gvayoy-web/DOMUS/assets/new/deliverables/execute/01_FINAL_V2/design/visor_mobile_390x844_cerrado.png

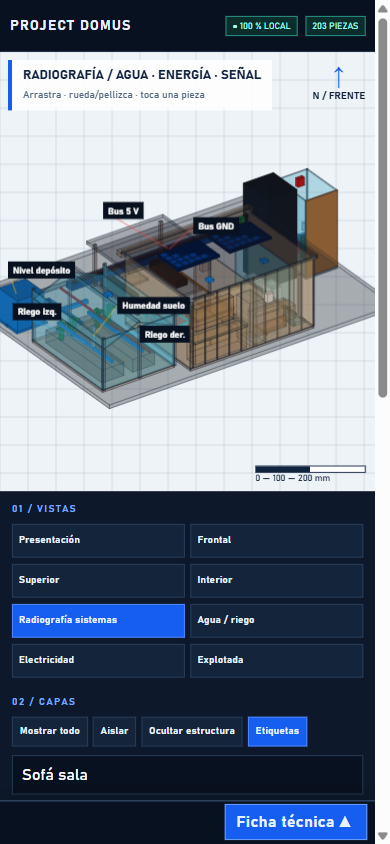
assets/new/deliverables/execute/01_FINAL_V2/design/visor_mobile_390x844_cerrado.png
