gvayoy-web/DOMUS/assets/new/deliverables/execute/01_FINAL_V2/design/visor_desktop_1440x900.png

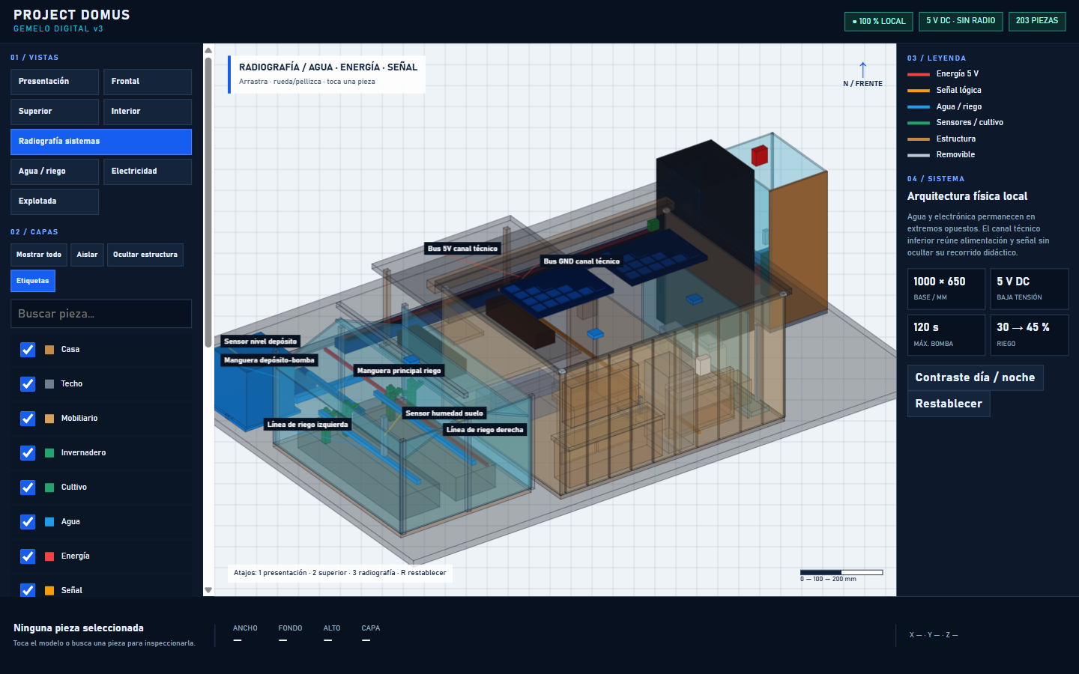
assets/new/deliverables/execute/01_FINAL_V2/design/visor_desktop_1440x900.png
