gvayoy-web/DOMUS/obsidian/proyect domus/07 - Precios y fuentes Honduras.md

---
proyecto: PROJECT DOMUS
tipo: fuentes
actualizado: 2026-09-01
estado: historico_precios
---

# Precios y fuentes en Honduras

> [!NOTE]
> Precios vistos el 1 de septiembre de 2026. Confirmar variante, existencia, envío y costo final a Choluteca en el carrito o por WhatsApp.

| Producto | Precio visto | Fuente |
|---|---:|---|
| Fuente 5 V/3 A USB-C con switch | L350 | [C&D — Fuente Raspberry Pi, elegir variante exacta](https://sps.cdtechnologia.net/2985-fuente-para-raspberry-pi3-pi4.html) |
| Relé 4 canales 5 V/10 A | L250 | [C&D — selector 1 a 8 canales](https://sps.cdtechnologia.net/2719-865-modulo-rele-5-24v-10a-1-8-canales.html) |
| MAX98357A | L130 | [C&D — amplificador I2S](https://sps.cdtechnologia.net/5855-modulo-amplificador-de-audio-i2s-max98357.html) |
| Altavoz 4 Ω/3 W | L90 | [C&D — parlante](https://sps.cdtechnologia.net/4094-parlante-4ohm-3w.html) |
| microSDHC 32 GB | L159 | [Steren Honduras — MSD-032ST](https://www.steren.com.hn/memoria-microsd-hc-de-32-gb-clase-uhs-iu1-v10-a1-con-adaptador-sd.html) |
| microSD Lexar 32 GB | L300 | [C&D — Lexar 32 GB FAT32](https://sps.cdtechnologia.net/4042-memoria-microsd-lexar-32-128gb.html) |
| Lector/escritor microSD SPI | L149 | [C&D — módulo lector microSD](https://sps.cdtechnologia.net/509-modulo-lector-y-escritor-de-tarjetas-micro-sd-compatible-con-arduino.html) |
| Jumpers set H/H + H/M + M/M | L250 | [C&D — Dupont 40 hilos](https://sps.cdtechnologia.net/118-1331-jumpers-de-conexion-dunpont-hh-mm-mh-40-hilos-20cm.html) |
| Conectores PCT, 4 unidades | L40 | [C&D — PCT](https://sps.cdtechnologia.net/2623-conector-de-cable-pct-2-pines-5-pines-4-unidades.html) |
| Portafusible aéreo 5×20 mm | L15 | [C&D — portafusible con cable](https://sps.cdtechnologia.net/3685-portafusible-con-cable.html) |
| Capacitores 1000 µF, 5 unidades | L35 | [C&D — selector electrolíticos](https://sps.cdtechnologia.net/179-capacitores-electroliticos-1-valor-01-1000uf-5-unidades.html) |
| Panel 5 V/1,100 mA | L280 | [C&D — selector panel 3–5.5 V](https://sps.cdtechnologia.net/4506-panel-solar-3v-55v.html) |
| CN3065 | L135 | [C&D — cargador solar](https://sps.cdtechnologia.net/4804-modulo-de-carga-baterias-de-litio-cn3065.html) |
| MT3608 USB-C | L90 | [C&D — elevador](https://sps.cdtechnologia.net/5077-estabilizador-regulador-ascendente-de-voltaje-dc-dc-mt3608-usb-c-2v-24v-a-5v-28v-2a.html) |
| BMS 1S 20 A | L85 | [C&D — sección baterías](https://sps.cdtechnologia.net/51-baterias) |
| 18650 BAK 2,500 mAh | L180 | [C&D — BAK](https://sps.cdtechnologia.net/5255-bateria-recargable-bak-18650-36v-2500mah-30a.html) |
| 18650 Steren 2,800 mAh | L249 | [Steren Honduras — 18650](https://www.steren.com.hn/bateria-recargable-li-ion-2800-mah-tipo-18650-1.html) |
| Portacelda individual 18650 | L55 | [C&D — sección baterías](https://sps.cdtechnologia.net/51-baterias) |
| KCD1-101 ON/OFF | L25 | [C&D — interruptor](https://sps.cdtechnologia.net/1612-interruptor-de-corriente-250v-6a-kcd1-101.html) |
| Palanca SPST 82600 | L55 | [Steren — switches](https://www.steren.com.hn/linea-estudiantil/switches-y-relevadores) |
| Capacitor 4700 µF/25 V | L60 | [C&D — capacitores grandes](https://sps.cdtechnologia.net/1701-capacitores-electroliticos-de-1000uf-2200uf-3300uf-4700uf-o-10000uf-1-valor-1-unidad.html) |
| Capacitor 6800 µF/25 V | L35 | [C&D — aparece como producto relacionado](https://sps.cdtechnologia.net/1701-capacitores-electroliticos-de-1000uf-2200uf-3300uf-4700uf-o-10000uf-1-valor-1-unidad.html) |

## Sin oferta hondureña verificada

- INMP441.
- 74AHCT125/74HCT14.
- Gestor solar 1S con power-path real y salida estable de 5 V/3 A.

No sustituirlos por productos con nombre parecido sin revisar interfaz y hoja de datos.

## Observaciones de envío

- Steren muestra compra en línea y en la página de la microSD indica que la tienda en línea puede entregar aun cuando no haya cobertura de tienda local.
- C&D publica venta en línea y contactos hondureños, pero el envío exacto a Choluteca debe confirmarse antes de pagar.
- El precio más bajo de microSD verificado es Steren L159. Una tarjeta va en el lector SPI del ESP32; comprar una segunda solo si se usará DFPlayer.
