gvayoy-web/DOMUS/obsidian/proyect domus/Bienvenido.md

---
estado: redireccion
fecha: 2026-09-14
---

# Bienvenido a PROJECT DOMUS

> [!IMPORTANT]
> Esta página sólo redirige. No contiene instrucciones de cableado.

Empieza en [[00 - Inicio]] y consulta [[63 - Auditoria total de Obsidian y estado real]].
Las notas antiguas conservan la evolución del proyecto, pero no sustituyen el
firmware, el diagrama vigente ni la auditoría 63.
