gvayoy-web/DOMUS/hardware/plano_tecnico_domus.pdf

PROJECT DOMUS · GEMELO DIGITAL v4

# PLANOS DE MAQUETA CRUDA

A3 apaisado · sin sensores, conexiones, cableado ni hidráulica instalada

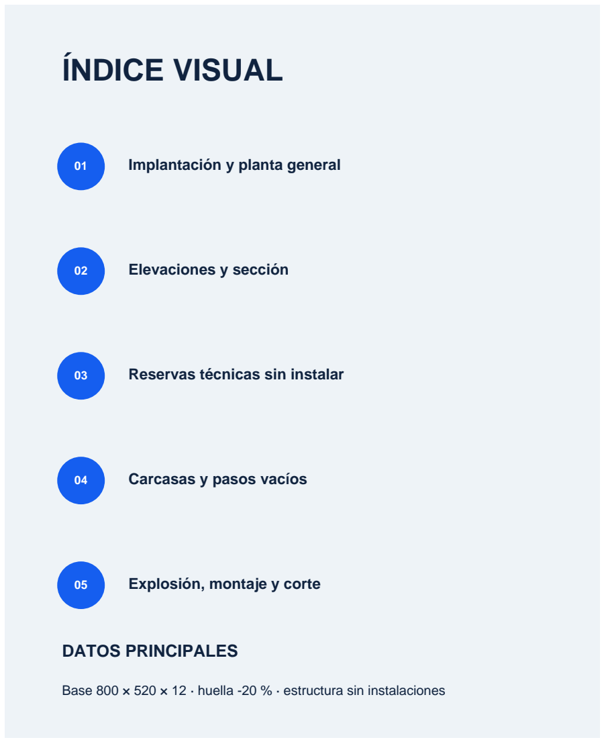
[picture p8: figure]
ÍNDICE VISUAL; 01 Implantación y planta general; 02 Elevaciones y sección; 03 Reservas técnicas sin instalar; 04 Carcasas y pasos vacíos; 05 Explosión, montaje y corte; DATOS PRINCIPALES

PL-00 · PÁGINA 1/6 · REV 4.0

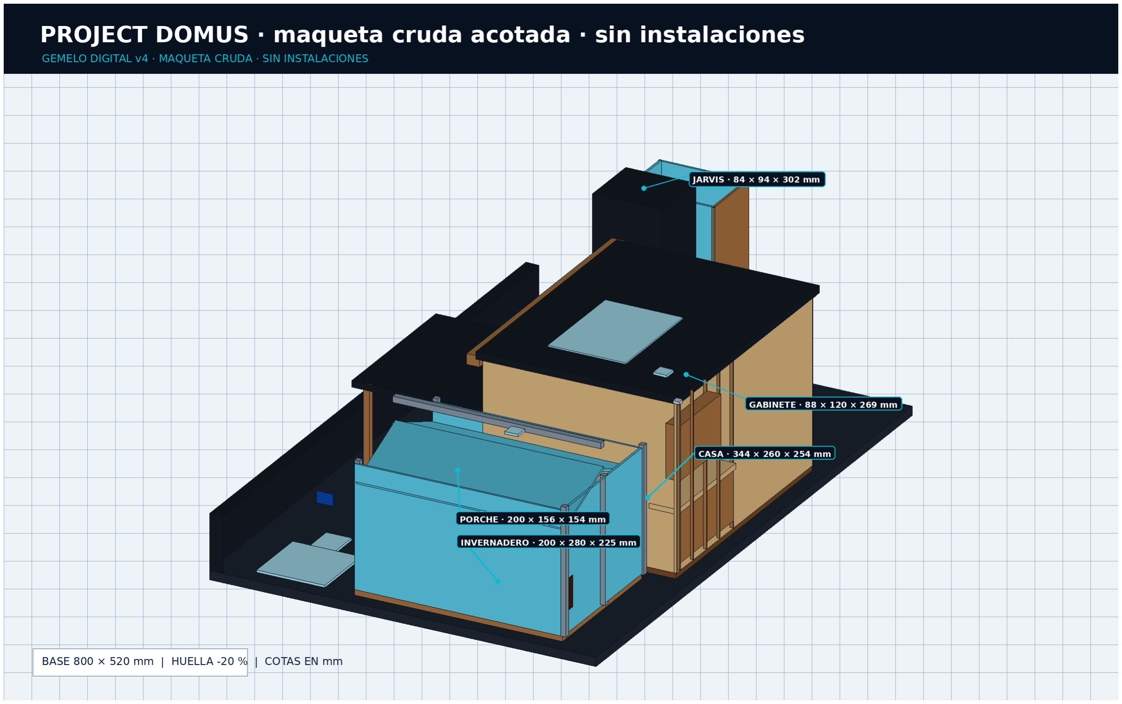
[picture p9: figure]

Base 800 × 520 × 12 · huella -20 % · estructura sin instalaciones

# IMPLANTACIÓN Y PLANTA GENERAL

Ejes, huellas y recorridos principales; el frente de exposición queda abajo

PL-01 · PÁGINA 2/6 · REV 4.0

INVERNADERO

VIVIENDA

PORCHE

JARVIS | GABINETE

AGUA

800

344 VIVIENDA

520

FRENTE / VISITANTE ↓

HUELLAS

- Invernadero 200 × 280 × 225
- Casa 344 × 260 × 254 total
- Porche 200 × 156 × 154
- Jarvis 84 × 94 × 302
- Gabinete 88 × 120 × 269
- Depósito real 92 × 92 × 100

ENTREGA DE MAQUETA CRUDA

Sin sensores, placas o conexiones.

Gabinete y Jarvis se entregan vacíos.

Canaleta inferior vacía con tapa.

Techo y frentes permanecen removibles.

# ELEVACIONES Y SECCIÓN

Alturas totales y lectura del interior abierto

PL-02 · PÁGINA 3/6 · REV 4.0

FRONTAL

344

84

SECCIÓN A-A

COCINA/SALA | DORMITORIO | BAÑO

TECHO REMOVIBLE

COTAS Z

302 torre Jarvis

269 gabinete

254 vivienda + techo

225 altura interior

225 invernadero

154 cubierta de porche

12 base estructural

ELEMENTOS REMOVIBLES

Techo · frente de gabinete · paneles de servicio

# RESERVAS TÉCNICAS · SIN INSTALACIONES

Marcar posiciones; no perforar hasta medir los componentes reales

PL-03 · PÁGINA 4/6 · REV 4.0

DEPÓSITO / 92×92
BOMBA / 48×34

JARVIS VACÍO
GABINETE VACÍO
SENSORES FUTUROS | LUCES FUTURAS | PANELES FUTUROS

REGLA PARA EL EQUIPO DE ARMADO

Construir las carcasas y marcar reservas con lápiz. No instalar placas, sensores, cables, bomba ni tubería.

# CARCASAS Y PASOS VACÍOS

Preparación mecánica para que el circuito se integre después

PL-04 · PÁGINA 5/6 · REV 4.0

### TORRE JARVIS

Frente removible; reserva pantalla/micrófono

### GABINETE

Frente removible; interior completamente vacío

### CANAL TÉCNICO

Tapa removible; no pasar cables todavía

### ENTREGA ESPERADA

1. Estructura firme y escuadrada. 2. Tapas removibles. 3. Reservas marcadas, sin agujeros definitivos.
4. Ninguna conexión, placa, sensor, actuador, manguera o fuente instalada.

# EXPLOSIÓN, MONTAJE Y CORTE

Secuencia de armado y criterios de tolerancia

PL-05 · PÁGINA 6/6 · REV 4.0

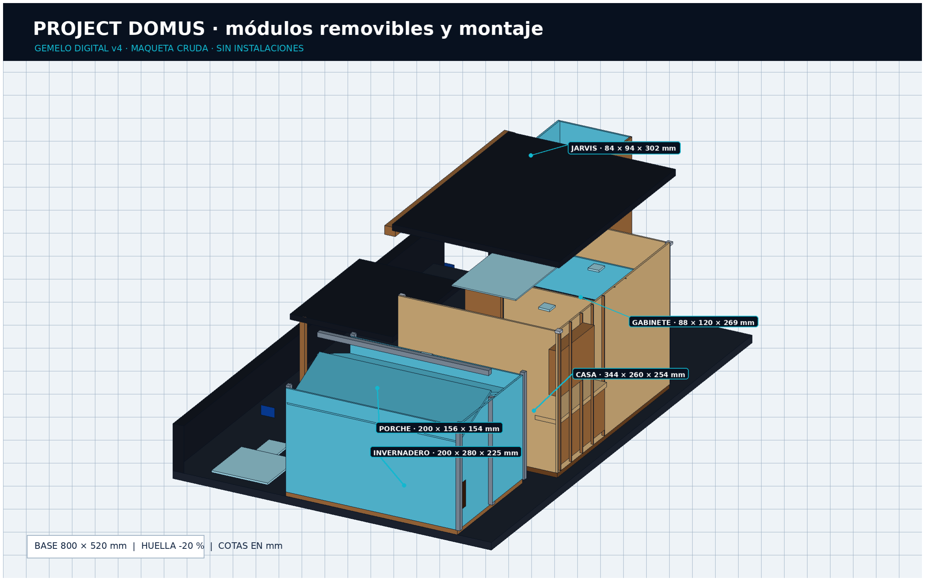
[picture p10: figure]

SECUENCIA

1 · Nivelar base 800 × 520.

2 · Marcar todas las huellas a lápiz.

3 · Montar casa y tabiques en seco.

4 · Armar porche e invernadero.

5 · Construir Jarvis y gabinete vacíos.

6 · Colocar canaleta vacía con tapa.

7 · Dejar techos y frentes removibles.

8 · Entregar sin conexiones ni perforaciones finales. TOLERANCIA INICIAL ±0.5 mm

Presentar en seco antes de adhesivo definitivo.

BASE

800×520×12

Cant. 1

CASA

344×260

Cant. 1 set

INVERNADERO

200×280×225

Cant. 1

PORCHE

200×156×154

Cant. 1

JARVIS

84×94×302

Cant. 1

GABINETE

88×120×269

Cant. 1
