gvayoy-web/DOMUS/assets/new/deliverables/execute/01_FINAL_V2/design/plano_tecnico_domus.pdf

# PROJECT DOMUS · PLANO TÉCNICO ACOTADO

Casa de una sola planta abierta al frente · cotas en milímetros · sistema totalmente local

## A · PLANTA GENERAL

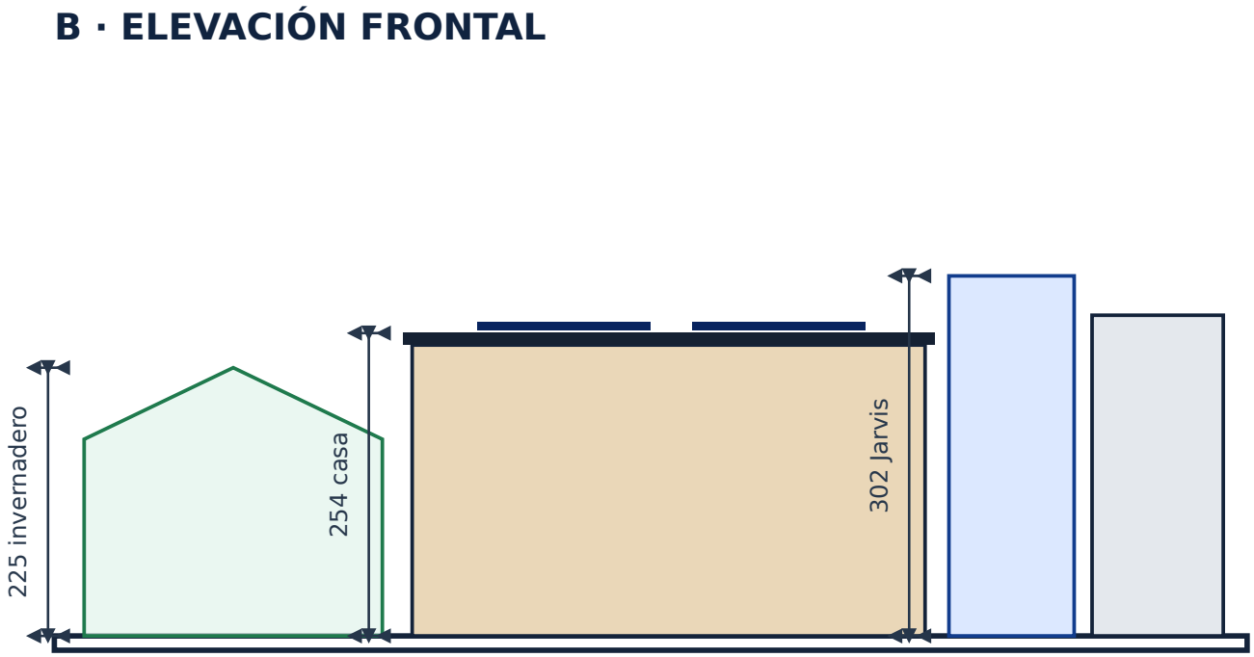
[picture p11: figure]
B · ELEVACIÓN FRONTAL 254 casa; 302 Jarvis; 225 invernadero

Frente abierto: interior visible sin desmontar una fachada

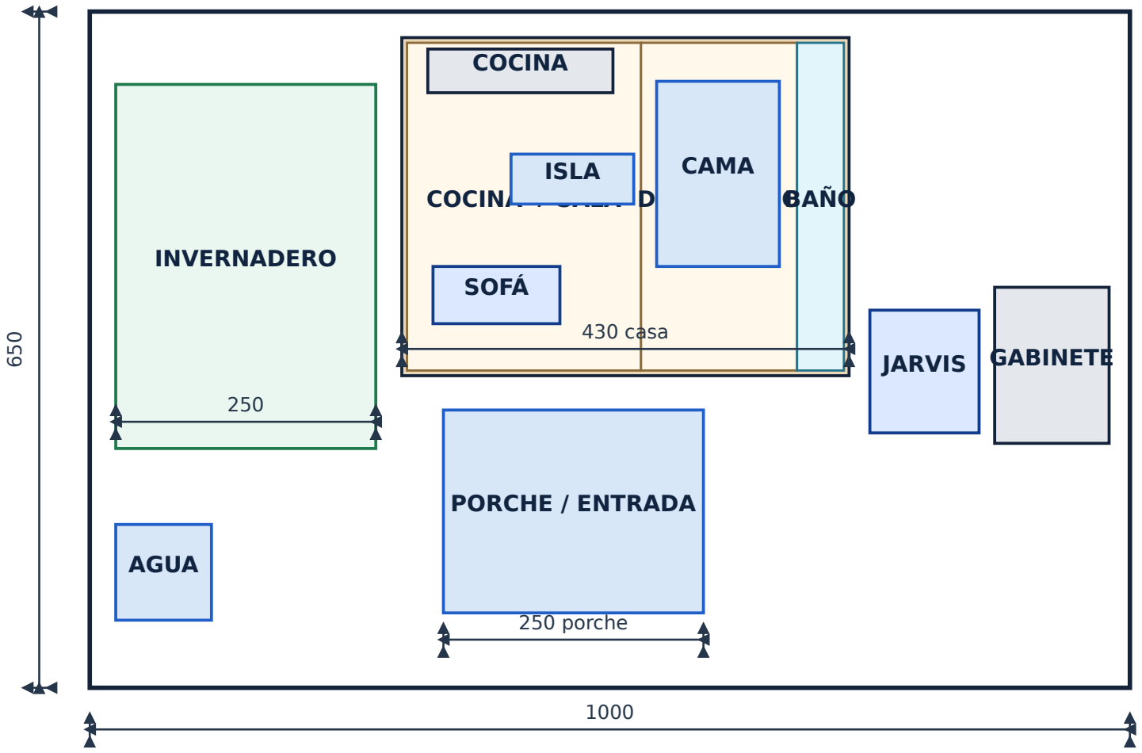
[picture p12: figure]
INVERNADERO; COCINA + SALA DORMITORIOBAÑO; PORCHE / ENTRADA; JARVIS GABINETE; AGUA; COCINA; ISLA; SOFÁ; CAMA; 430 casa; 250 porche

## C · ELEVACIÓN LATERAL DERECHA

## D · MEDIDAS PRINCIPALES

Base negra: 1000 × 650 × 12

Vivienda: 430 × 325 × 254 total · interior libre 225 de alto Invernadero: 250 × 350 × 225 · panel transparente 1–2

Porche: 250 × 195 × 154 · pasarela frontal de 58

Torre Jarvis: 105 × 118 × 302 · gabinete: 110 × 150 × 269

## E · CRITERIOS DE MONTAJE

- Una sola planta; no existe escalera ni entrepiso.
- Techo removible; fachada abierta; gabinete electrónico desmontable.
- Depósito y bomba al extremo opuesto del ESP32-S3.
- Cableado por canaleta inferior; alimentación general de 5 V DC.

SIN Wi-Fi · SIN Bluetooth/BLE · SIN teléfono · SIN nube

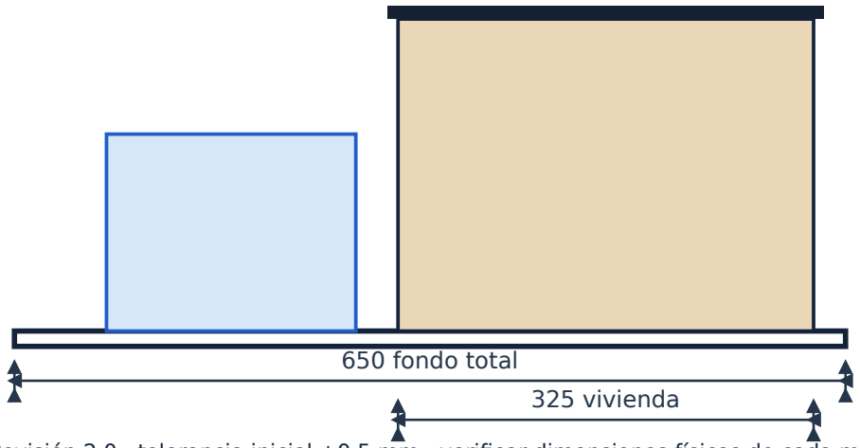
[picture p13: figure]
650 fondo total; 325 vivienda

Revisión 2.0 · tolerancia inicial ±0.5 mm · verificar dimensiones físicas de cada módulo antes del corte definitivo
