gvayoy-web/DOMUS/output/pdf/planos_tecnicos_project_domus.pdf

PROJECT DOMUS · GEMELO DIGITAL v3

# JUEGO DE PLANOS TÉCNICOS

A3 apaisado · cotas en milímetros · maqueta educativa de baja tensión

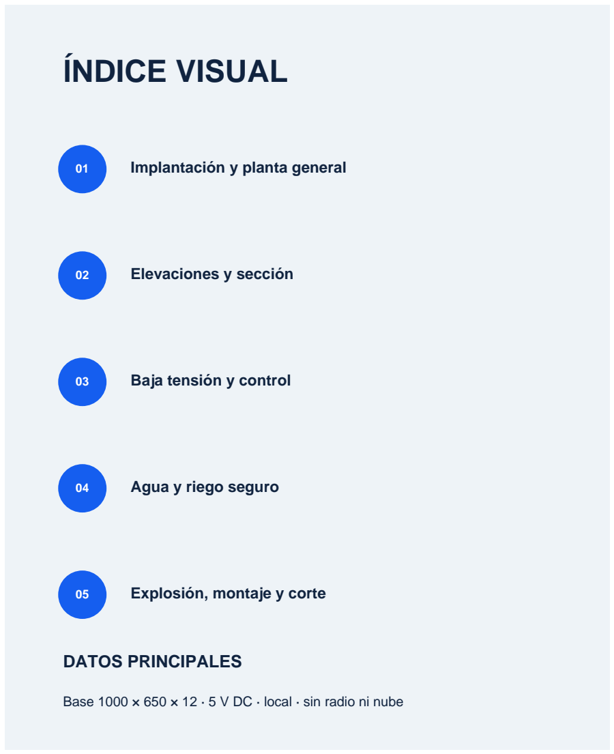
[picture p14: figure]
ÍNDICE VISUAL; 01 Implantación y planta general; 02 Elevaciones y sección; 03 Baja tensión y control; 04 Agua y riego seguro; 05 Explosión, montaje y corte; DATOS PRINCIPALES

PL-00 · PÁGINA 1/6 · REV 3.0

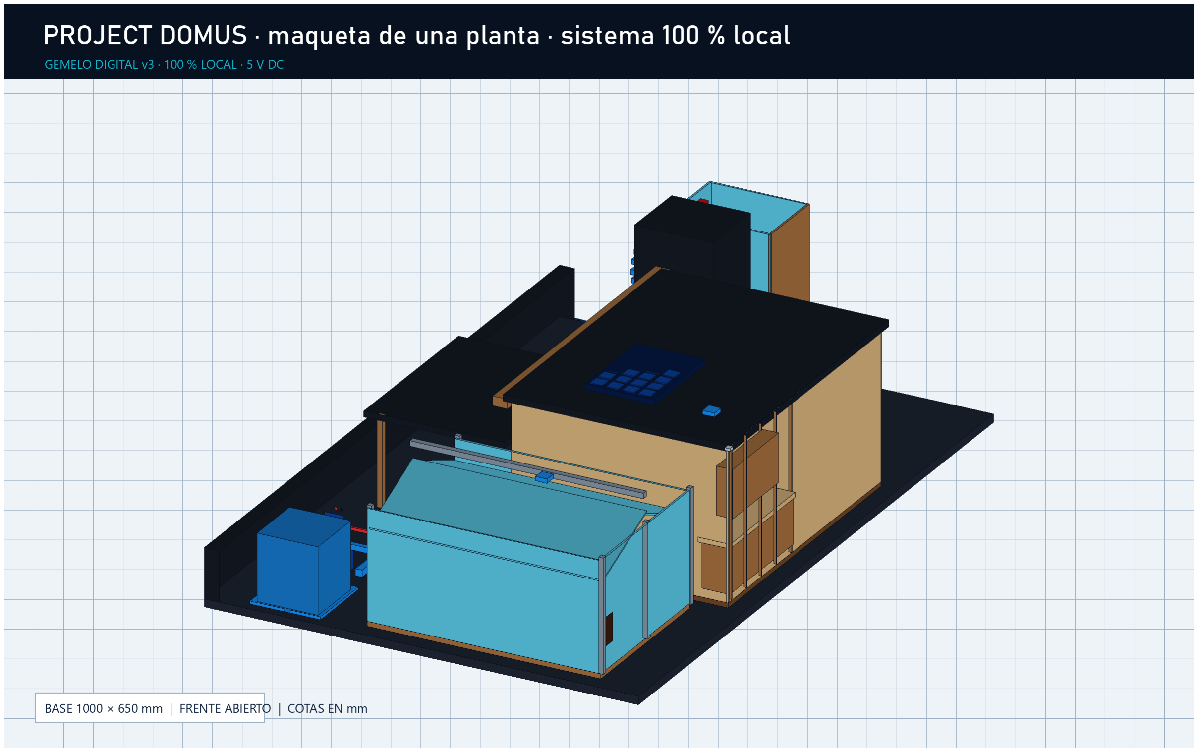
[picture p15: figure]

Base 1000 × 650 × 12 · 5 V DC · local · sin radio ni nube

# IMPLANTACIÓN Y PLANTA GENERAL

Ejes, huellas y recorridos principales; el frente de exposición queda abajo

PL-01 · PÁGINA 2/6 · REV 3.0

INVERNADERO

VIVIENDA

PORCHE

JARVIS | GABINETE

AGUA

1000

430 VIVIENDA

650

FRENTE / VISITANTE ↓

HUELLAS

- Invernadero 250 × 350 × 225
- Casa 430 × 325 × 254 total
- Porche 250 × 195 × 154
- Jarvis 105 × 118 × 302
- Gabinete 110 × 150 × 269
- Depósito 92 × 92 × 100

SEPARACIÓN FUNCIONAL

Agua al extremo izquierdo.

Control al extremo derecho.

Canaleta inferior con tapa.

Techo y gabinete removibles.

# ELEVACIONES Y SECCIÓN

Alturas totales y lectura del interior abierto

PL-02 · PÁGINA 3/6 · REV 3.0

FRONTAL

430

105

SECCIÓN A-A

COCINA/SALA | DORMITORIO | BAÑO

TECHO REMOVIBLE

COTAS Z

302 torre Jarvis

269 gabinete

254 vivienda + techo

225 altura interior

225 invernadero

154 cubierta de porche

12 base estructural

ELEMENTOS REMOVIBLES

Techo · frente de gabinete · paneles de servicio

# PLANO ELÉCTRICO · BAJA TENSIÓN

Diagrama funcional; usar la tabla de cableado validada para GPIO concretos

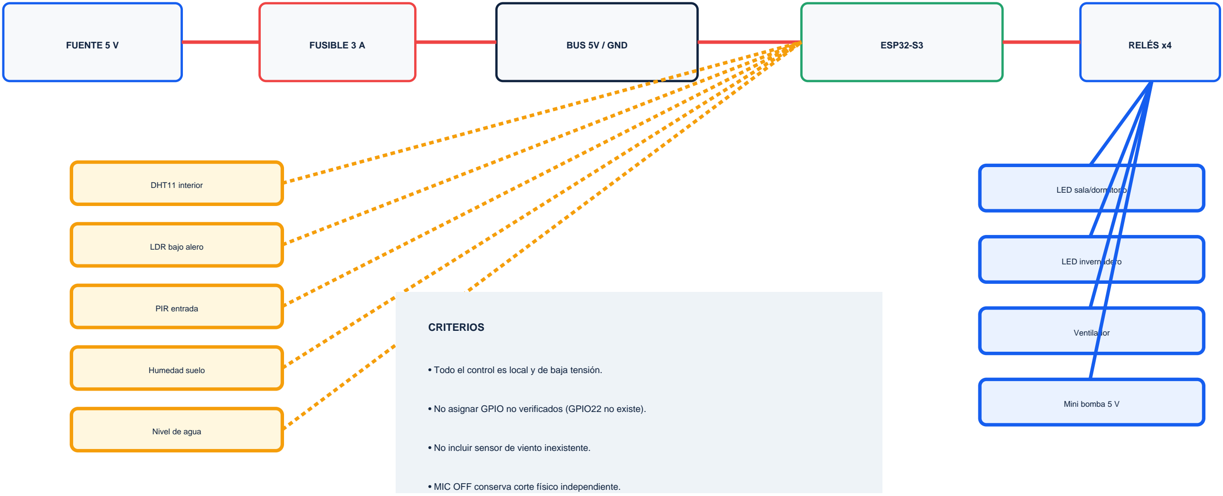
[picture p16: figure]
FUENTE 5 V; FUSIBLE 3 A; BUS 5V / GND; ESP32-S3; RELÉS x4; DHT11 interior; LDR bajo alero; PIR entrada; Humedad suelo; Nivel de agua; LED sala/dormitorio; LED invernadero; Ventilador; Mini bomba 5 V; CRITERIOS

PL-03 · PÁGINA 4/6 · REV 3.0

- Todo el control es local y de baja tensión.
- No asignar GPIO no verificados (GPIO22 no existe).
- No incluir sensor de viento inexistente.
- MIC OFF conserva corte físico independiente.

# PLANO HIDRÁULICO · RIEGO SEGURO

Depósito separado, lectura de nivel y bloqueo de bomba

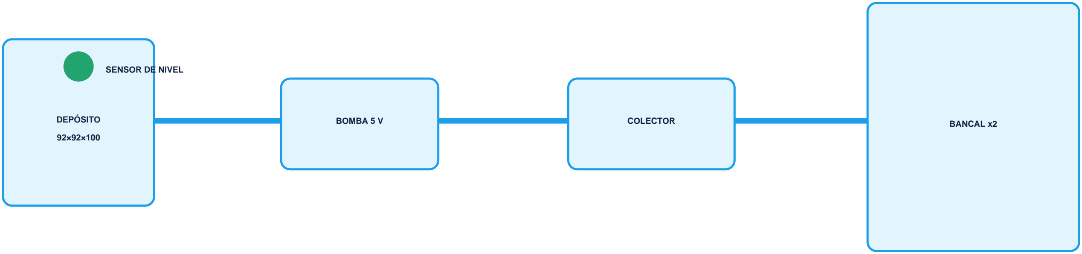
[picture p17: figure]
DEPÓSITO; BOMBA 5 V; COLECTOR; BANCAL x2; SENSOR DE NIVEL

PL-04 · PÁGINA 5/6 · REV 3.0

### LÓGICA DE PROTECCIÓN

1. Humedad < 30 % → solicitud de riego.
2. Nivel bajo → bomba bloqueada y alarma local.
3. Nivel suficiente → riego hasta 45 %.
4. Tiempo máximo de bomba: 120 s.

Nunca ubicar agua o uniones de manguera sobre el gabinete electrónico.

# EXPLOSIÓN, MONTAJE Y CORTE

Secuencia de armado y criterios de tolerancia

PL-05 · PÁGINA 6/6 · REV 3.0

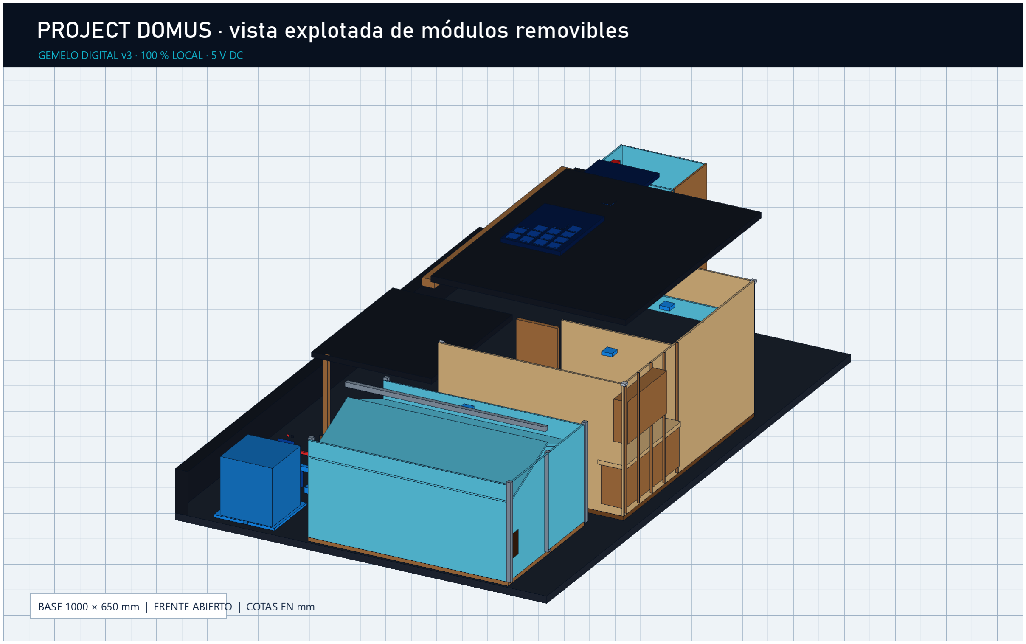
[picture p18: figure]

SECUENCIA

1 · Nivelar base 1000 × 650.

2 · Montar casa y tabiques.

3 · Armar porche e invernadero.

4 · Separar depósito y gabinete.

5 · Tender agua antes de energía.

6 · Cablear 5 V/GND y señales.

7 · Colocar techo/paneles removibles.

8 · Probar bloqueos antes de exhibir. TOLERANCIA INICIAL ±0.5 mm

Presentar en seco antes de adhesivo definitivo.

BASE

1000×650×12

Cant. 1

CASA

430×325

Cant. 1 set

INVERNADERO

250×350×225

Cant. 1

PORCHE

250×195×154

Cant. 1

JARVIS

105×118×302

Cant. 1

GABINETE

110×150×269

Cant. 1
