gvayoy-web/DOMUS/documentos/README.md

# Documentos de PROJECT DOMUS

Estos DOCX son entregables redactados en distintas etapas. La autoridad técnica actual está en [Obsidian 63](../obsidian/proyect%20domus/63%20-%20Auditoria%20total%20de%20Obsidian%20y%20estado%20real.md) y el cableado del banco en el [SVG vigente](../visualizaciones/domus-banco-final-s8050-ir.svg). No comprar ni cablear solo desde un DOCX.

| Archivo | Uso |
|---|---|
| Proyecto_Tecnico_PROJECT_DOMUS_ACTUALIZADO.docx | Revisión posterior del proyecto técnico |
| Proyecto_Tecnico_PROJECT_DOMUS_ACTUALIZADO_ENERGIA_SOLAR.docx | Variante histórica con energía solar; solar funcional está descartada |
| Guia_Construccion_PROJECT_DOMUS_ACTUALIZADO.docx | Revisión posterior de la guía constructiva |
| Lista_de_Compras_y_Fallas_Reales_PROJECT_DOMUS.docx | Registro de compras y fallas de su fecha |
| historico/ | Primeras versiones de la guía y el proyecto técnico |

Los planos fuente actuales están en hardware/planos/.
