gvayoy-web/DOMUS/output/README.md

# Exportaciones

pdf/ reúne archivos para imprimir o consultar; los generadores están en tools/ y hardware/planos/. El Markdown de factibilidad se conserva aquí por su relación con esas exportaciones. El código, los planos fuente y la bóveda son la autoridad actual; este directorio contiene resultados generados.
