gvayoy-web/DOMUS/obsidian/proyect domus/50 - Ola 1 buffers Jarvis GPIO12 y validacion por perfil.md

---
proyecto: PROJECT DOMUS
tipo: ola-correccion-firmware
actualizado: 2026-09-12
estado: aplicado_ola_1
perfil: ALFA_UN_COSTADO_SIN_IR
---

# Ola 1 — buffers, Jarvis único, GPIO12 y validación por perfil

Aplica las prioridades 1-7 del dictamen conjunto (revisor + filtro Isaac).
Guía vigente: [[47 - Guia visual principiante conexiones alfa]].
Potencia vigente: [[49 - Prueba de una carga con un S8050 y TP4056]].
Autoridad: [[46 - Plan maestro de consolidacion un costado]].

## Qué estaba mal

1. `PantallaBonita::feedback()` conservaba `const char*` del llamador. Con
   `char buf[17]` local desde `ejecutarTeclaIR()` leía memoria liberada.
2. `VozJarvis::ultima_` conservaba puntero sin copiar. Frágil aunque hoy use literales.
3. `alternarIR()` emitía `voz.dice()` y el llamador repetía otra frase: doble Jarvis.
4. Las rutas sala/dormitorio/cultivo/ventilador emitían `ACK;IR;...` incluso si
   `alternarIR()` ya había emitido `NACK` → ACK/NACK contradictorios.
5. `pinesUnicos()` validaba lista manual, no funciones activas. No veía alias
   buzzer/IR en GPIO12 ni DF/BOTÓN en 18 ni DF/SDA en 17.
6. `VozJarvis::begin()` configuraba GPIO12 y `beep()` lo ponía HIGH aunque
   IR/DF estuvieran off. El SVG decía “GPIO12 libre”: discrepancia activa.
7. `splash()` bloqueaba ~640 ms con `delay(40)x16`; `beep()` bloqueaba con `delay()`.

## Cambios aplicados (código)

| Archivo | Cambio | Efecto |
|---|---|---|
| `firmware/domus_esqueleto/domus_lcd.h` | `feedbackTitulo_/Sub_[17]` buffers + `snprintf`; `splash()` sin `delay`, solo título + feedback | Fin del dangling `buf`; arranque no bloqueante |
| `firmware/domus_esqueleto/domus_voice.h` | `ultima_[160]` con copia; `BUZZER_HABILITADO` gatea `begin/beep`; `beep()` programa pulsos, `actualizar()` los ejecuta sin `delay` | GPIO12 intacto si buzzer off; loop no se congela |
| `firmware/domus_esqueleto/domus_config.h` | `BUZZER_HABILITADO=false`; PIN_IR/DF marcados FINAL-ONLY; `listaActiva()/funcionesActivasSinAlias()` + `static_assert`; `PERFIL_ALFA_BOMBA_1/VENTILADOR_1` explícitos | Compilación falla si funciones HABILITADAS comparten GPIO; un motor por compilación |
| `firmware/domus_esqueleto/domus_esqueleto.ino` | `alternarIR()` solo feedback + bool; llamadores emiten UNA frase + ACK solo si `true`; `loop()` llama `voz.actualizar()`; `DOMUS_LISTO` incluye `BUZZER=` | Una Jarvis por pulsación; sin ACK tras NACK |
| `visualizaciones/domus-alfa-guia-principiantes.svg` | “GPIO12 libre” → “GPIO12 reservado, sin conectar (buzzer deshabilitado en alfa)” | Doc = firmware |
| `visualizaciones/domus-alfa-motores-s8050.svg` | Título “HISTÓRICO — NO CABLEAR”, subtítulo a `una-carga` + nota 49 | No montar 2xS8050 |
| `obsidian/proyect domus/46 - Plan maestro…` | Cultivo G11→G8, G12 reservado, nota ola 1 | Mapa candidato = firmware |
| `obsidian/proyect domus/47 - Guia visual…` | GPIO12 reservado, procedimiento PIR 3V3→medir, ref nota 50 | Guía = firmware |

## Perfiles de motor (nota 49)

```text
normal ALFA_UN_COSTADO_SIN_IR -> GPIO4 y GPIO7 bloqueados
ALFA_BOMBA_1      -> HABILITAR_MOTOR_BOMBA=true,  VENTILADOR=false (solo GPIO4)
ALFA_VENTILADOR_1 -> HABILITAR_MOTOR_VENTILADOR=true, BOMBA=false (solo GPIO7)
```

Nunca ambos en `true` (static_assert). S8550 queda en reserva, fuera del circuito.

## PIR vigente

```text
Primera prueba: VCC a 3V3.
Si no detecta movimiento:
- identificar el módulo;
- probar alimentación a 5V;
- medir OUT antes de conectarlo al ESP32;
- OUT debe permanecer ≤3.3V.
```

## Verificación pendiente (ola 1)

- [x] Compilación N16R8/OPI sin warnings nuevos del esqueleto (382278B/25620B)
- [x] Tests contrato (LCD copia, ACK único, GPIO activos, buzzer off = GPIO12 intacto)
- [x] `validate_project.py` actualizado a selección única + GPIO15/16/17 (corrección entrega)
- [ ] HIL solo después de lo anterior

## Corrección de entrega 3 (auditoría REQUEST CHANGES 3, 2026-09-12)

Las banderas `-DDOMUS_IR/-DDOMUS_DF/-DDOMUS_BUZZER` reabrían GPIO12 en alfa.
Cierre: `static_assert(DOMUS_IR==0 / DOMUS_DF==0 / DOMUS_BUZZER==0)` en todo
perfil alfa; esas opciones quedan reservadas al futuro perfil FINAL. La matriz
negativa las rechaza con ese mensaje (no con el de alias, que queda como
segunda barrera para el FINAL).

* `check_perfil_matrix.py`: usa arduino-cli local o del PATH (CI); sin
  toolchain falla con código 2 salvo `--allow-skip` consciente.
* CI `firmware-ci.yml`: job `compilar-perfiles-alfa` (0/1/2) + job
  `rechazos-perfil-alfa` que ejecuta la matriz completa.
* Evidencia binaria: `.bin` de cada perfil contiene solo su nombre
  (`ALFA_UN_COSTADO_SIN_IR` / `ALFA_BOMBA_1` / `ALFA_VENTILADOR_1`).

## Corrección de entrega 2 (auditoría REQUEST CHANGES 2, 2026-09-12)

Sin reescribir lo publicado; commits pequeños nuevos:

1. Diodo: `domus-alfa-una-carga-s8050.svg` dibuja el 1N4007 como símbolo
   (barra cátodo + triángulo), raya→OUT+, sin raya→C; advierte que no es cable.
2. README: bomba/ventilador como usos alternativos del único S8050; cultivo
   LED directo a GPIO8 (1 kΩ por LED); inventario 1xS8050 + S8550 reserva.
3. Notas 43/44/45: banner + metadata histórico/superado, autoridad 46/47/49/50.
4-5. Selección compilable: `-DDOMUS_PERFIL_ALFA=0/1/2`,
   `-DDOMUS_BUZZER/-DDOMUS_IR/-DDOMUS_DF`; CI (`firmware-ci.yml`) construye
   los 3 perfiles; `tools/check_perfil_matrix.py` verifica 3 OK + 3 rechazos.
6. Rechazos probados por compilación real (no solo booleanos): perfil 3,
   IR+buzzer en GPIO12, DFPlayer en 17/18.
7. `PERFIL_PRUEBA = nombrePerfil(PERFIL_HARDWARE)`: DIAGNOSTICO/BANCO/LISTO
   reportan el perfil seleccionado (`ALFA_UN_COSTADO_SIN_IR` por defecto).

## Corrección de entrega 1 (auditoría REQUEST CHANGES, 2026-09-12)

La auditoría rechazó el commit `7102224` por no reproducible aislado. Correctivo
pequeño, sin reescribir el publicado:

1. `PerfilHardware` pasa a selección única (`ALFA_SENSORES` por defecto) y
   `HABILITAR_MOTOR_BOMBA/VENTILADOR` derivan de ella; alias `PERFIL_ALFA_BOMBA_1`
   / `VENTILADOR_1` conservados. Archivo: `domus_config.h`.
2. Matriz de compilación parametrizada (`motoresExclusivos`, `alias12Ok`,
   `dfSinAlias`): 5 casos que compilan + 3 prohibidos afirmados negados + 3 del
   perfil real. Archivo: `domus_config.h`.
3. Tests de contrato extendidos a ola 1 (selección única, matriz, buffers,
   Jarvis único + ACK condicional, SVG GPIO12). Archivos:
   `firmware/tests/test_domus_esqueleto_contract.py`,
   `firmware/tests/test_hil_esqueleto.py` (perfil alfa).
4. README operativo: GPIO12 reservado + Jarvis sin buzzer en alfa. Archivo:
   `firmware/domus_esqueleto/README.md`.
5. SVG `domus-alfa-una-carga-s8050.svg` incluido en seguimiento (estaba untracked).
6. Validador: cheques en forma de selección única; `planos/new` opcional.
   Las pruebas `planos/tests` siguen estrictas: fallan en árbol sucio porque
   `planos/new/*` está borrado sin commitear (condición preexistente, fuera de
   este commit); en checkout limpio del commit existen y pasan. Resolver el
   duelo `planos/new` vs `planos/planos` queda para ola 2 (ítem 11).

## Relaciones

- [[46 - Plan maestro de consolidacion un costado]]
- [[47 - Guia visual principiante conexiones alfa]]
- [[48 - Guia principiante transistores bomba y ventilador]]
- [[49 - Prueba de una carga con un S8050 y TP4056]]
