gvayoy-web/DOMUS/docs/aegis/work/2026-09-06-domus-base-funcional/20-checkpoint.md

# Punto de control final

- Completado: modulo de control, sketch funcional, protocolo, calibracion NVS,
  LCD/DHT, automatizacion, seguridad, pruebas, CI y fuente de estado.
- Evidencia: compilacion ESP32-S3 PASS; validador PASS; diff-check PASS.
- Bloqueo externo: pruebas electricas y de duracion requieren la placa montada.
- Proximo paso: ejecutar B01-B10 de la nota 33.
- Deriva: ninguna; voz, SD, red, bateria y solar permanecen fuera.
