gvayoy-web/DOMUS/hardware/planos/modelo_3d_interactivo.html

PROJECT DOMUSMAQUETA CRUDA v4 · GEOMETRÍA ACOTADA

● OFFLINESIN INSTALACIONES0 PIEZAS

01 / VISTAS

IsométricaFrontalPlantaInteriorEstructura y canal vacíoReservas técnicasCarcasas vacíasExplotada

02 / CAPAS

TodasAislar selecciónOcultar estructura

MAQUETA CRUDA / ISOMÉTRICAArrastra · rueda/pellizca · toca una pieza

↑N / FRENTE

0 — 100 — 200 mm

Sin conexiones: las piezas transparentes marcan reservas para instalar componentes después.

03 / HERRAMIENTAS

Cotas 3DEtiquetasGiro automáticoRecorridoGuardar PNGPantalla completa

Separación de módulos Opacidad estructural

04 / LEYENDA

Reserva futuraCarcasa vacíaCanal técnico vacíoCultivo decorativoEstructura

05 / COTAS CLAVE

800 × 520BASE / MM

344 × 260VIVIENDA

200 × 280INVERNADERO

84 × 94.4 × 302JARVIS TOTAL

Escala fiel al original: todas las posiciones y huellas estructurales se redujeron exactamente 20 %.

Día / nocheRestablecer

Ninguna pieza seleccionadaToca una pieza para ver su ficha exacta.

ANCHO—FONDO—ALTO—CAPA—

X — · Y — · Z —
