gvayoy-web/DOMUS/assets/new/deliverables/execute/01_FINAL_V2/design/modelo_3d_interactivo.html

PROJECT DOMUS

GEMELO DIGITAL v3

● 100 % LOCAL5 V DC · SIN RADIO0 PIEZAS

01 / VISTAS

PresentaciónFrontalSuperiorInteriorRadiografía sistemasAgua / riegoElectricidadExplotada

02 / CAPAS

Mostrar todoAislarOcultar estructuraEtiquetas

PRESENTACIÓN / ISOMÉTRICAArrastra · rueda/pellizca · toca una pieza

↑

N / FRENTE

0 — 100 — 200 mm

Atajos: 1 presentación · 2 superior · 3 radiografía · R restablecer

03 / LEYENDA

Energía 5 VSeñal lógicaAgua / riegoSensores / cultivoEstructuraRemovible

04 / SISTEMA

## Arquitectura física local

Agua y electrónica permanecen en extremos opuestos. El canal técnico inferior reúne alimentación y señal sin ocultar su recorrido didáctico.

1000 × 650BASE / MM

5 V DCBAJA TENSIÓN

120 sMÁX. BOMBA

30 → 45 %RIEGO

Contraste día / nocheRestablecer

Ficha técnica ▲

Ninguna pieza seleccionadaToca el modelo o busca una pieza para inspeccionarla.

ANCHO—

FONDO—

ALTO—

CAPA—

X — · Y — · Z —
