gvayoy-web/DOMUS/assets/new/deliverables/execute/02_HISTORIAL_V1/design/modelo_3d_interactivo.html

# PROJECT DOMUS

100 % offline

Arrastra sobre el modelo para girarlo. Usa la rueda para acercar. El visor no realiza conexiones de red.

Rotación Elevación Zoom Restablecer vista

## Capas

Base 1000 × 700 mm
Casa 620 × 380 mm
PB 220 mm · PA 210 mm
Jarvis y servicio removibles
