gvayoy-web/DOMUS/assets/new/deliverables/execute/01_FINAL_V2/design/plano_v3_pagina-6.png

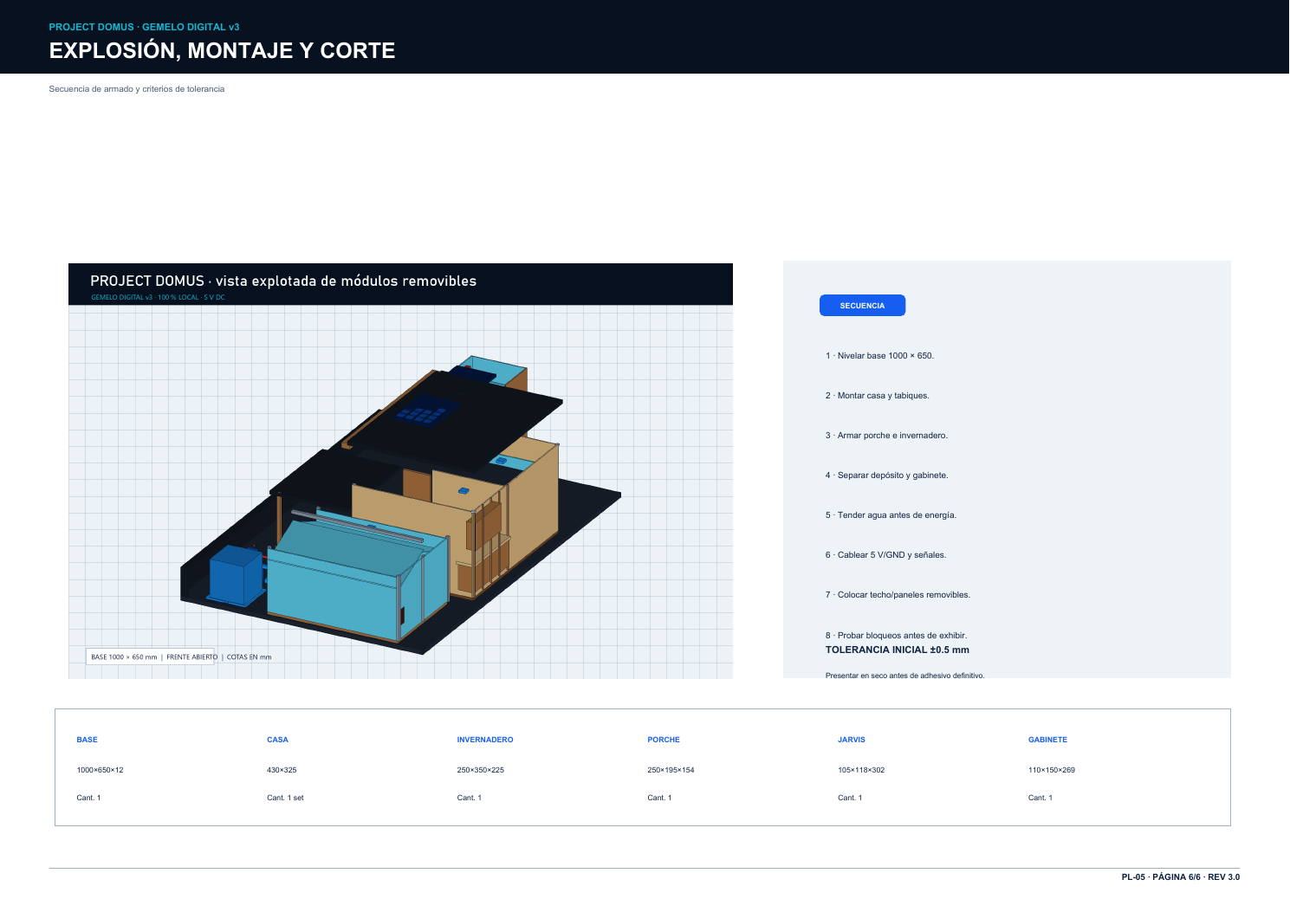
assets/new/deliverables/execute/01_FINAL_V2/design/plano_v3_pagina-6.png
