gvayoy-web/DOMUS/assets/new/deliverables/execute/01_FINAL_V2/design/project_domus_cutaway.png

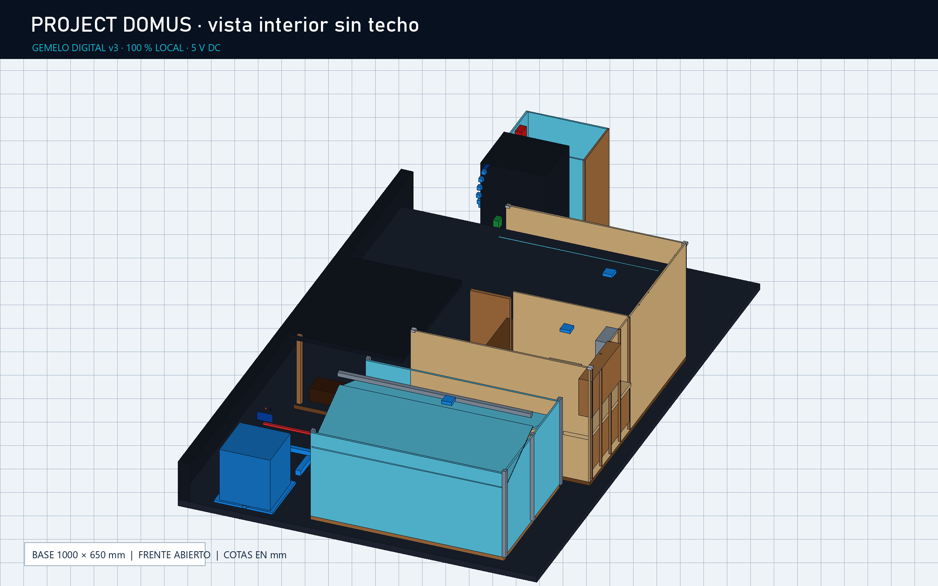
assets/new/deliverables/execute/01_FINAL_V2/design/project_domus_cutaway.png
