gvayoy-web/DOMUS/assets/new/deliverables/execute/02_HISTORIAL_V1/design/plano_tecnico_domus_preview.png

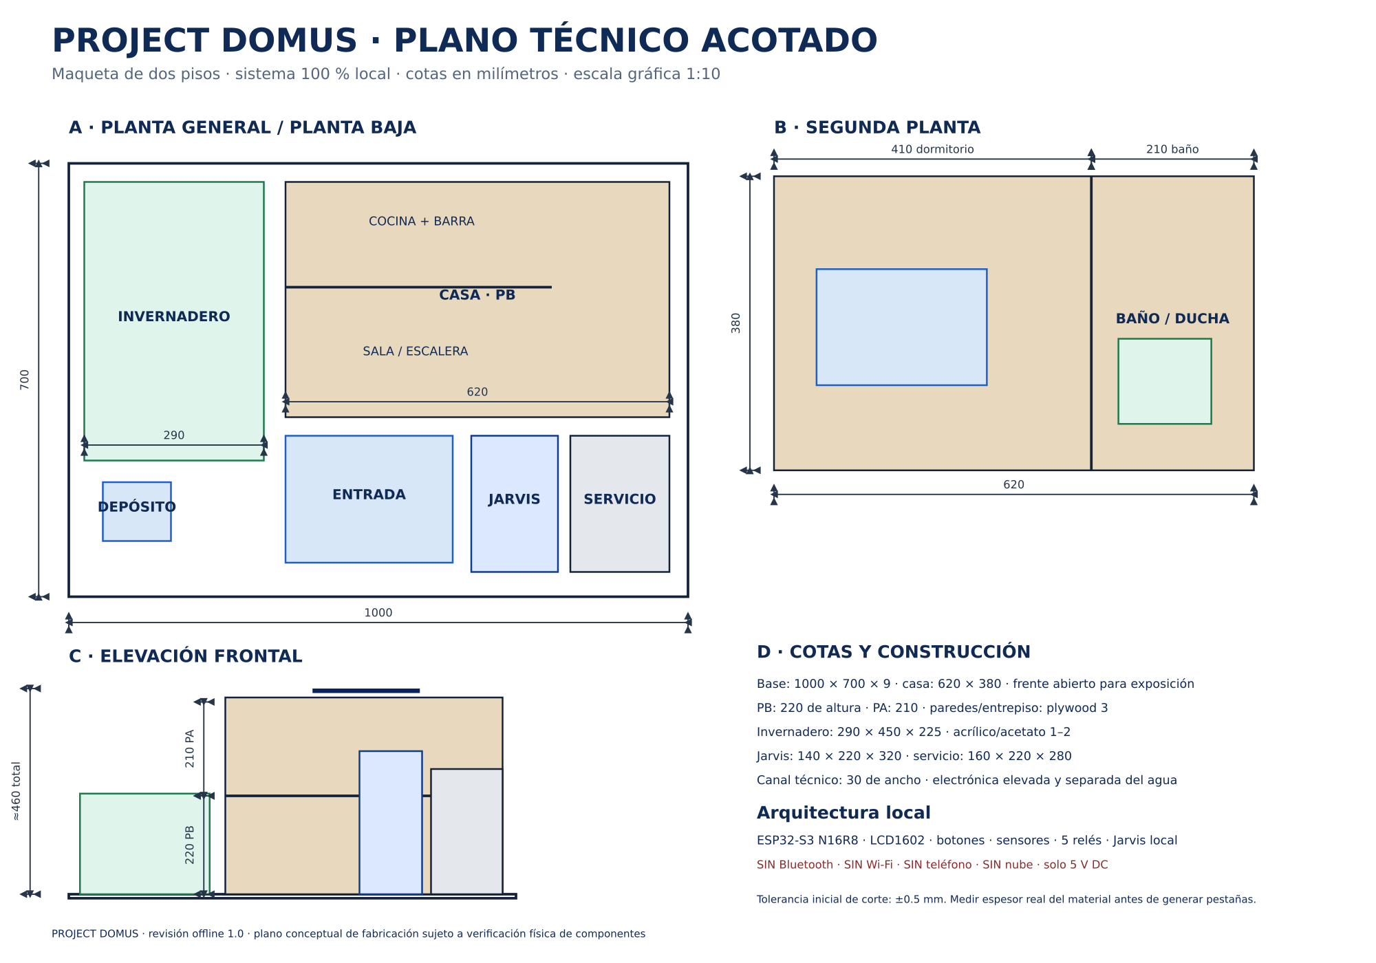
assets/new/deliverables/execute/02_HISTORIAL_V1/design/plano_tecnico_domus_preview.png
