gvayoy-web/DOMUS/assets/new/deliverables/execute/04_REFERENCIA/01-Screenshot_20260901-220639_Docs.jpg

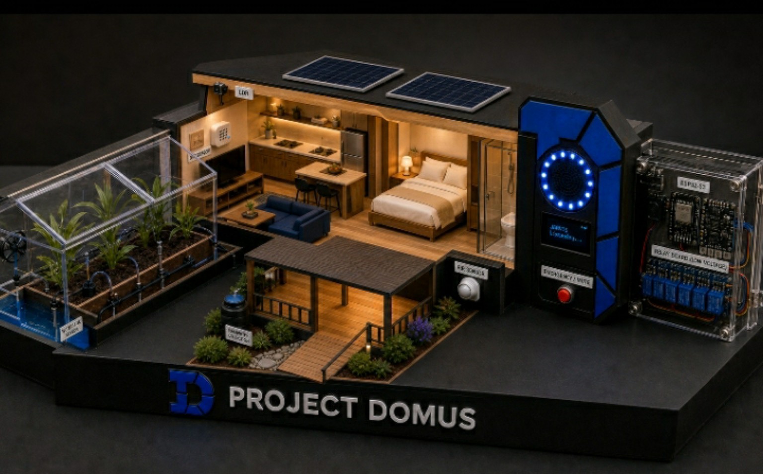
assets/new/deliverables/execute/04_REFERENCIA/01-Screenshot_20260901-220639_Docs.jpg
