gvayoy-web/DOMUS/assets/plano_tecnico_domus_opcion_a.png

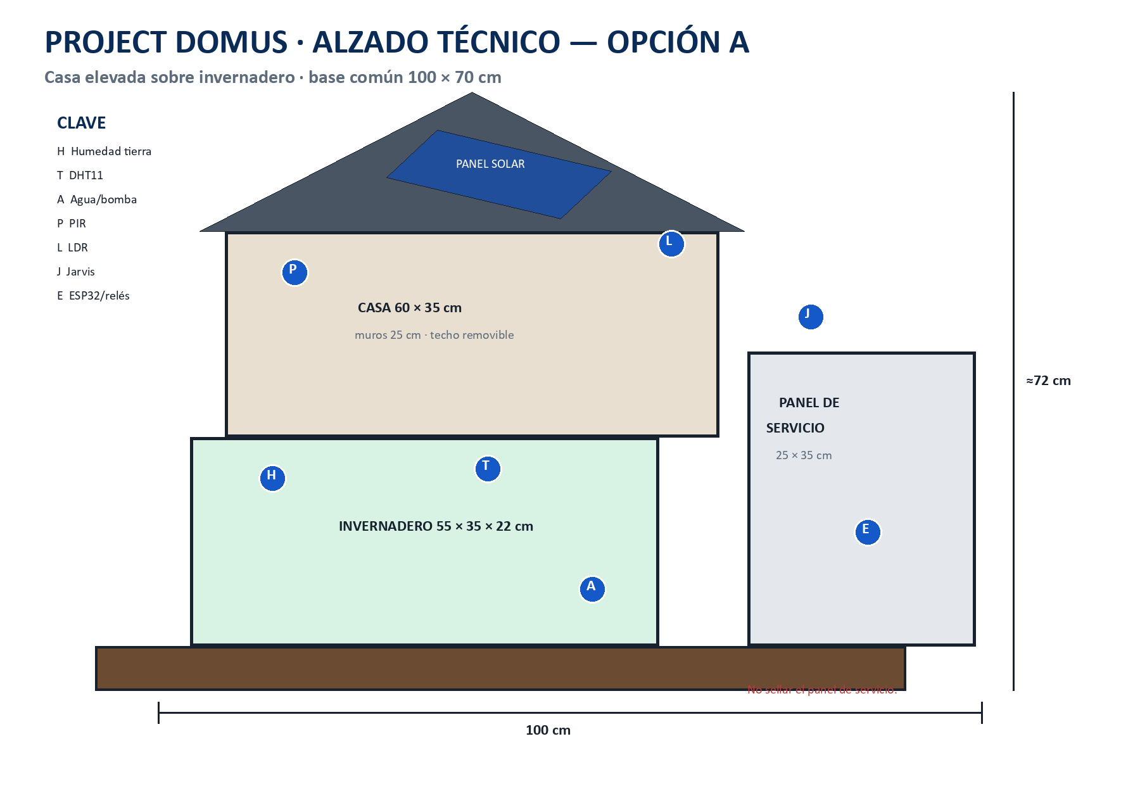
assets/plano_tecnico_domus_opcion_a.png
