gvayoy-web/DOMUS/assets/project_domus_maqueta_final.png

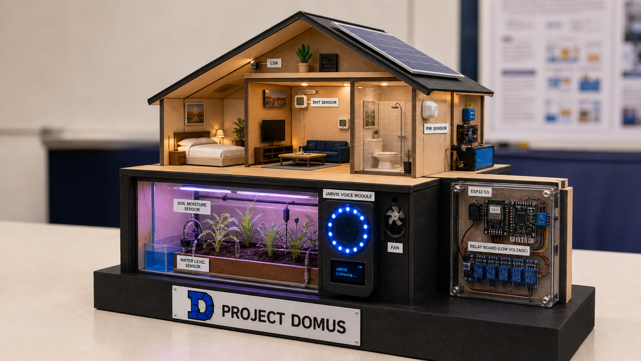
assets/project_domus_maqueta_final.png
