gvayoy-web/DOMUS/assets/project_domus_maqueta_final_v2.png

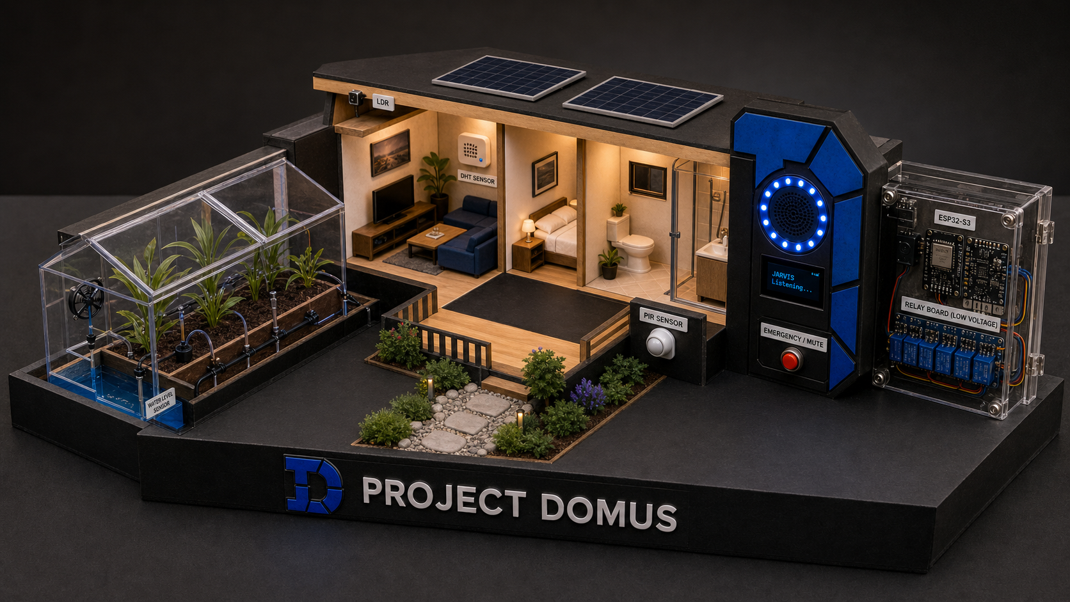
assets/project_domus_maqueta_final_v2.png
