gvayoy-web/DOMUS/hardware/planos/PLANOS_ULTIMATE_MASTER_8K.png

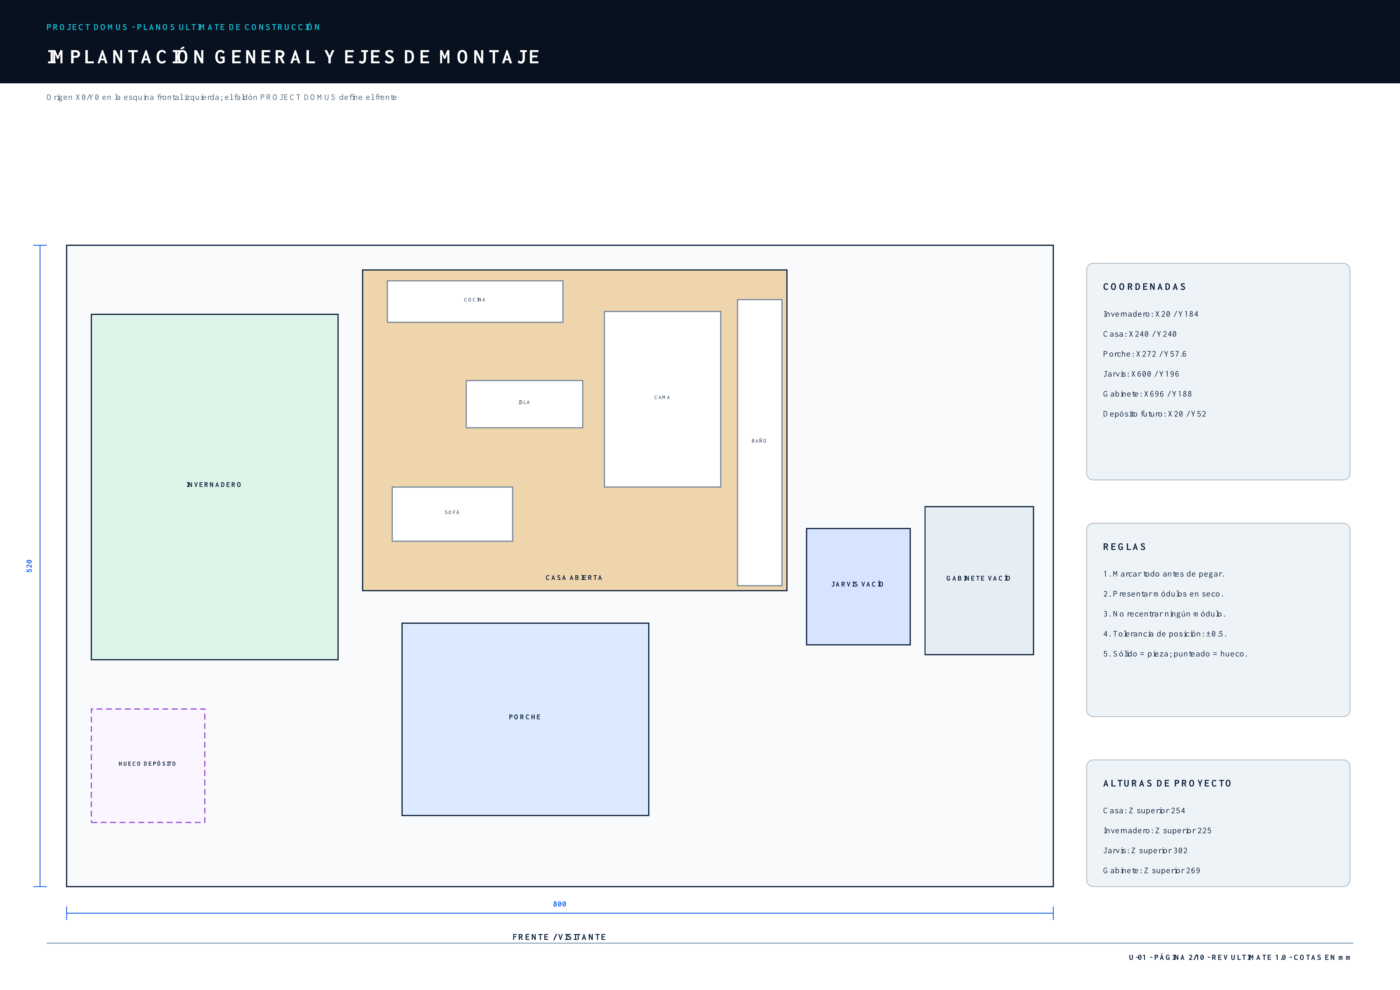
hardware/planos/PLANOS_ULTIMATE_MASTER_8K.png
