gvayoy-web/DOMUS/hardware/planos/PLANOS_ULTIMATE_PNG_300DPI/lamina-01.png

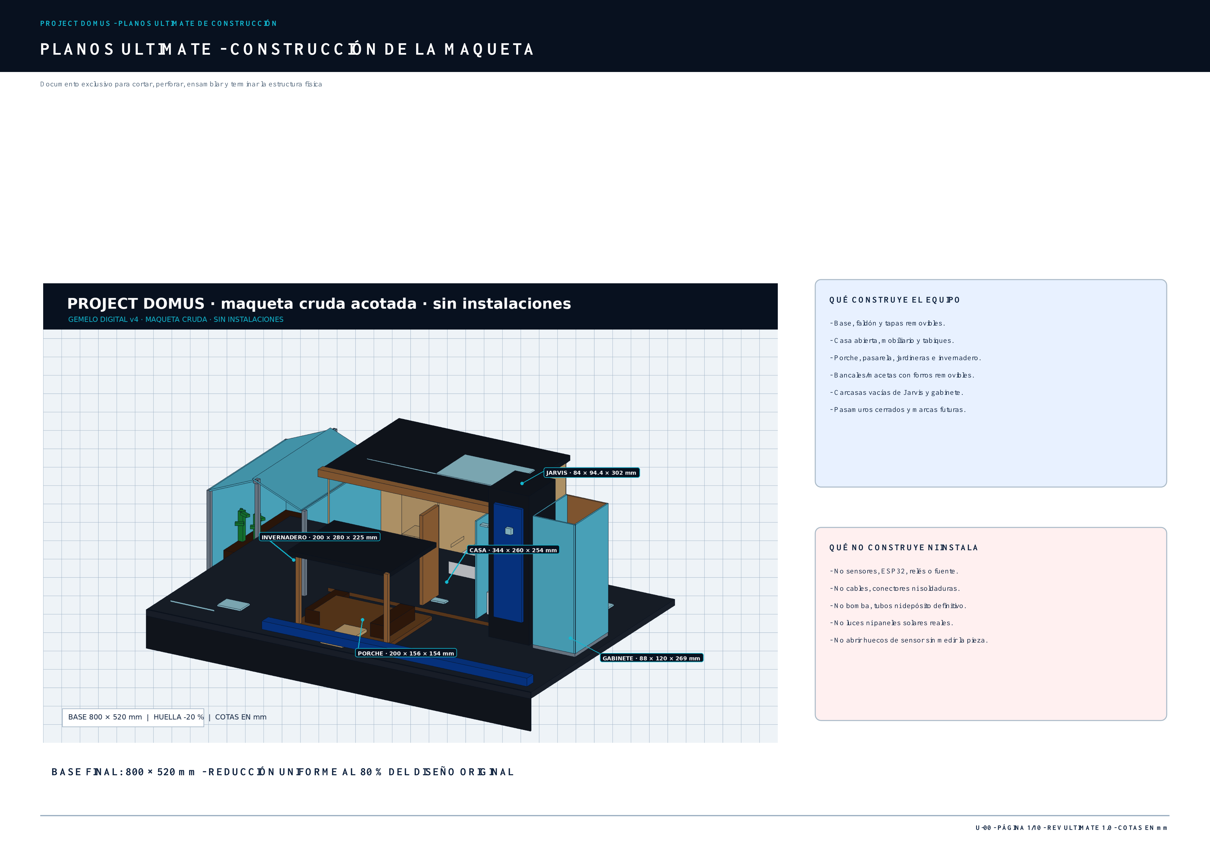
hardware/planos/PLANOS_ULTIMATE_PNG_300DPI/lamina-01.png
