gvayoy-web/DOMUS/hardware/planos/PLANOS_ULTIMATE_PNG_300DPI/lamina-03.png

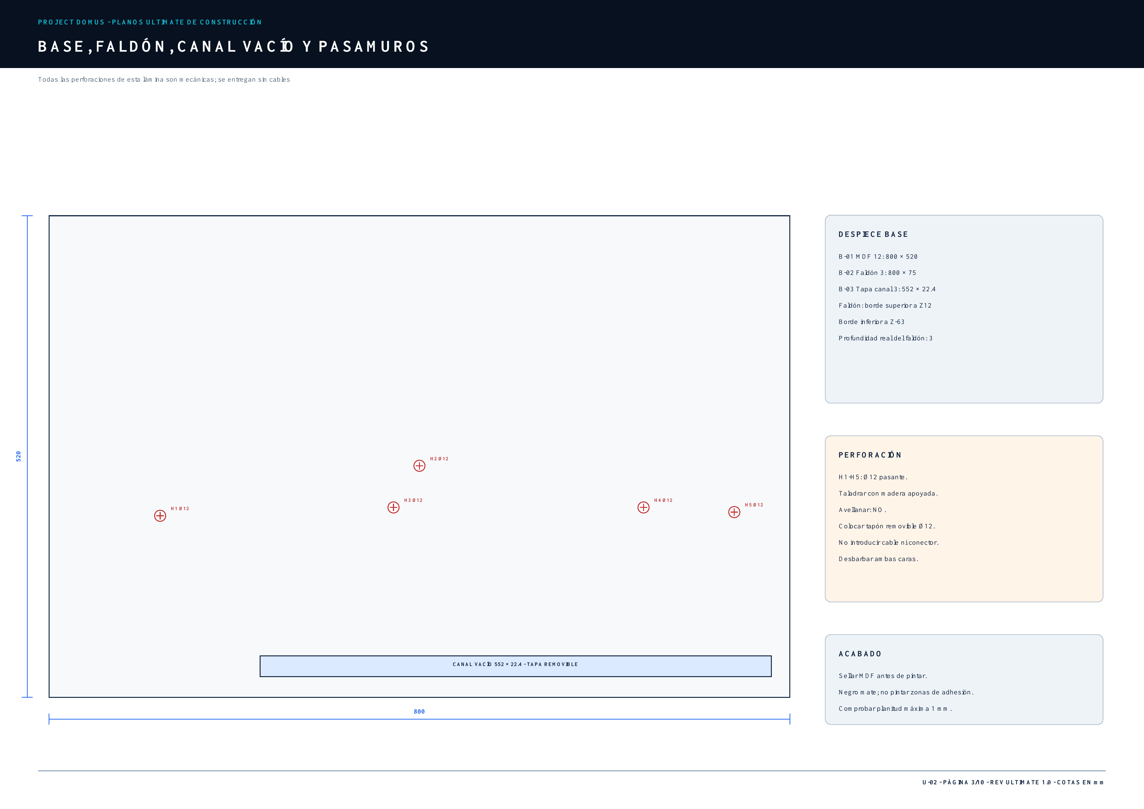
hardware/planos/PLANOS_ULTIMATE_PNG_300DPI/lamina-03.png
