gvayoy-web/DOMUS/hardware/planos/PLANOS_ULTIMATE_PNG_300DPI/lamina-09.png

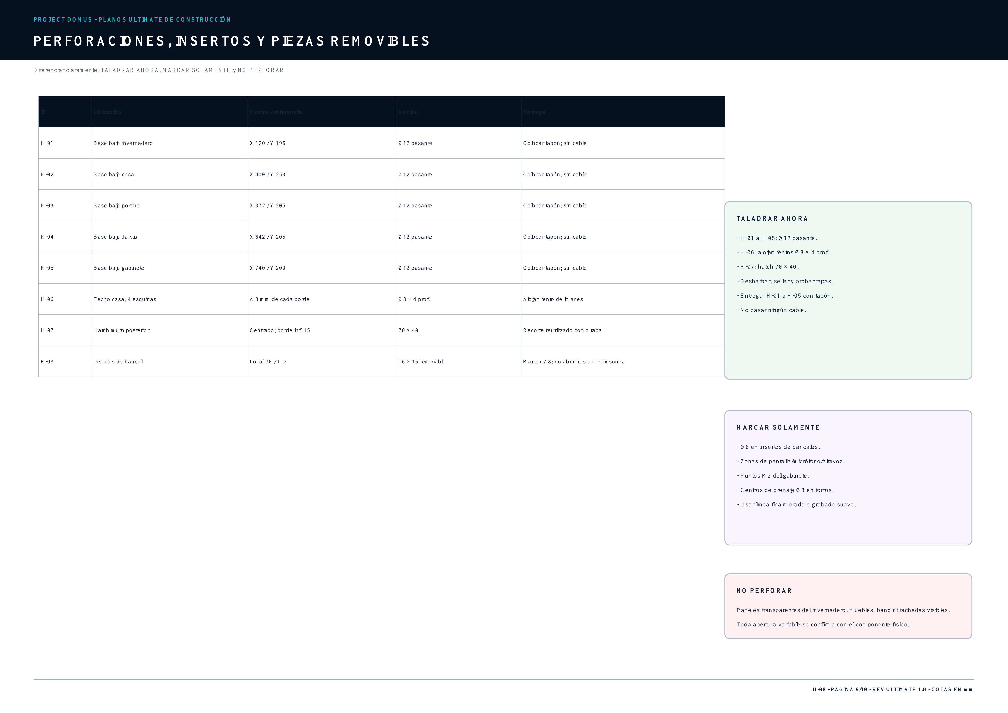
hardware/planos/PLANOS_ULTIMATE_PNG_300DPI/lamina-09.png
