gvayoy-web/DOMUS/hardware/planos/PLANOS_ULTIMATE_TODAS_LAMINAS_ALTA_RES.jpg

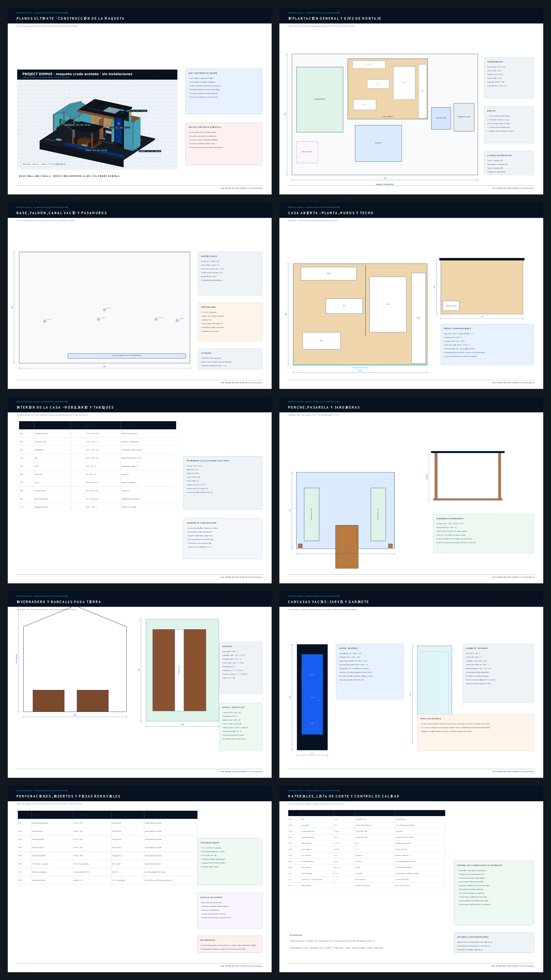
hardware/planos/PLANOS_ULTIMATE_TODAS_LAMINAS_ALTA_RES.jpg
