gvayoy-web/DOMUS/hardware/planos/project_domus_cutaway.png

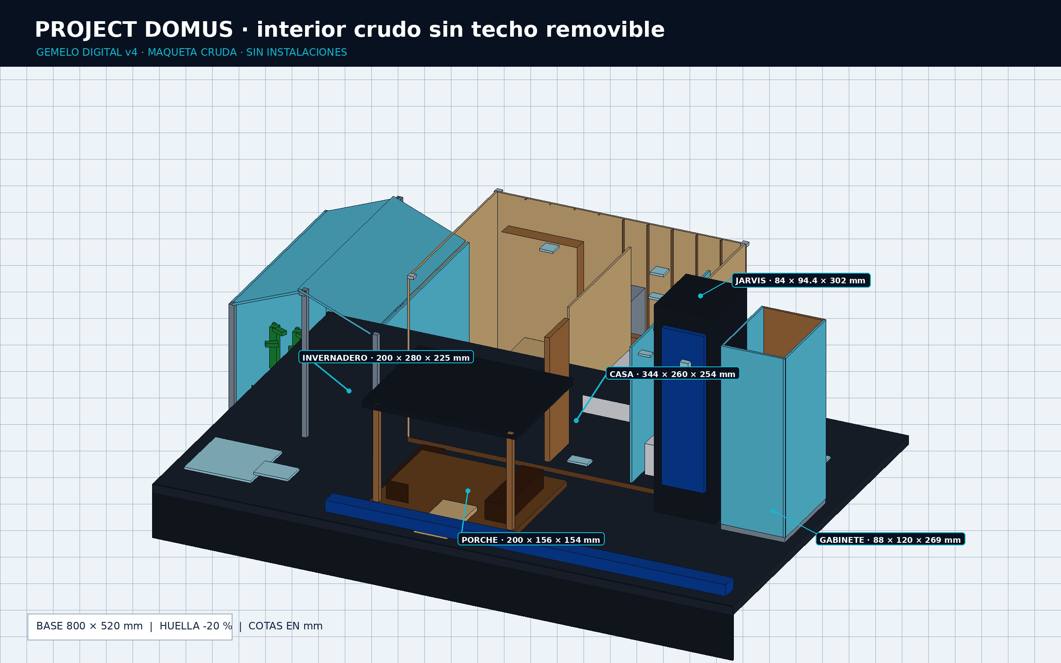
hardware/planos/project_domus_cutaway.png
