gvayoy-web/DOMUS/hardware/planos/project_domus_exploded.png

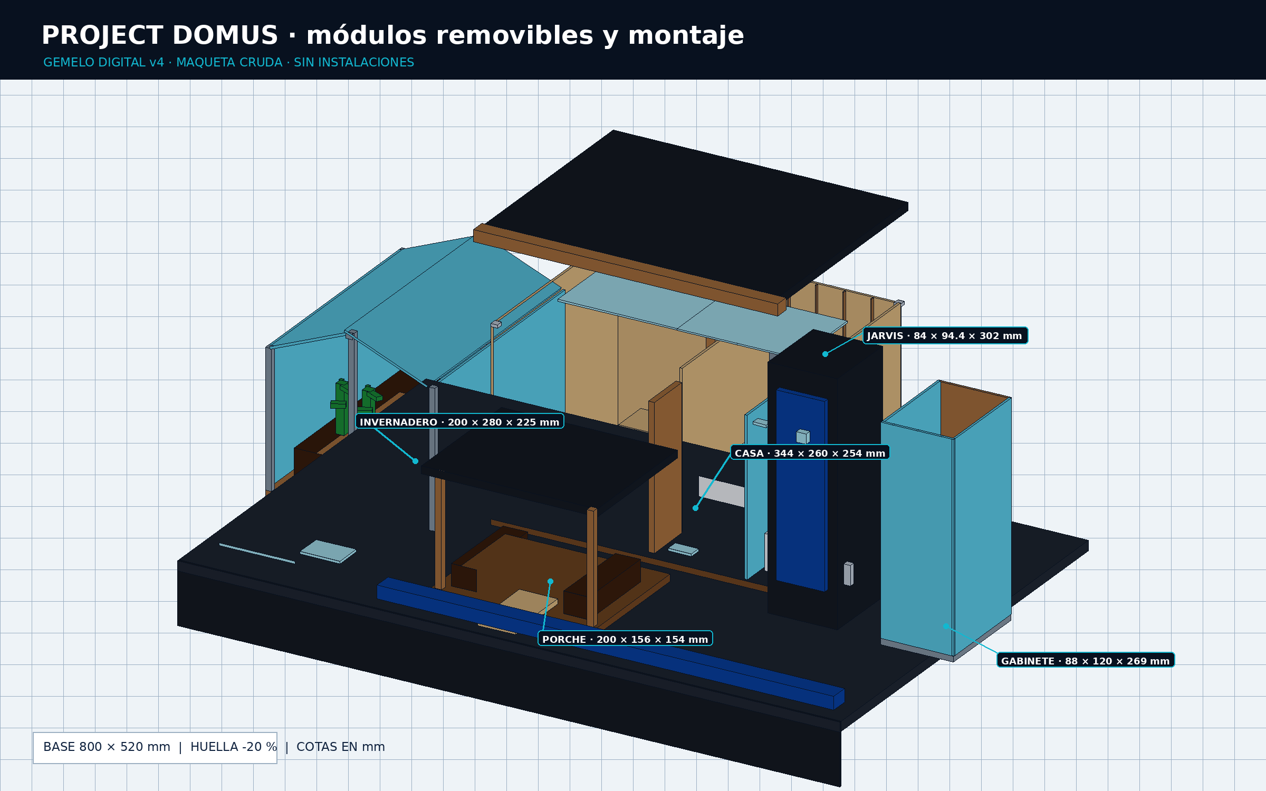
hardware/planos/project_domus_exploded.png
