gvayoy-web/DOMUS/hardware/planos/project_domus_final_concept_v3.png

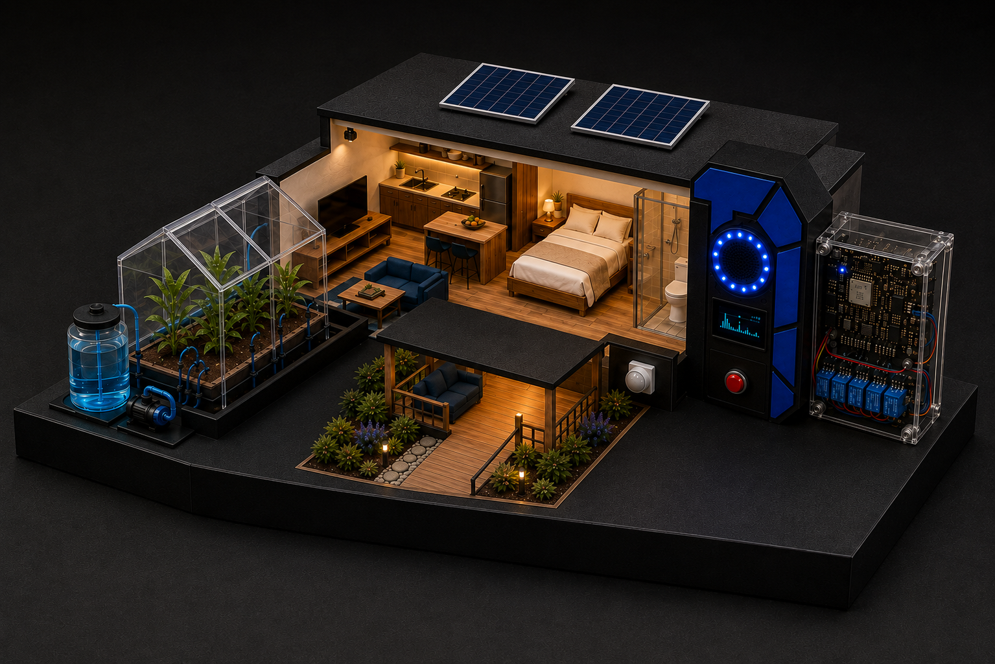
hardware/planos/project_domus_final_concept_v3.png
