gvayoy-web/DOMUS/hardware/planos/project_domus_render.png

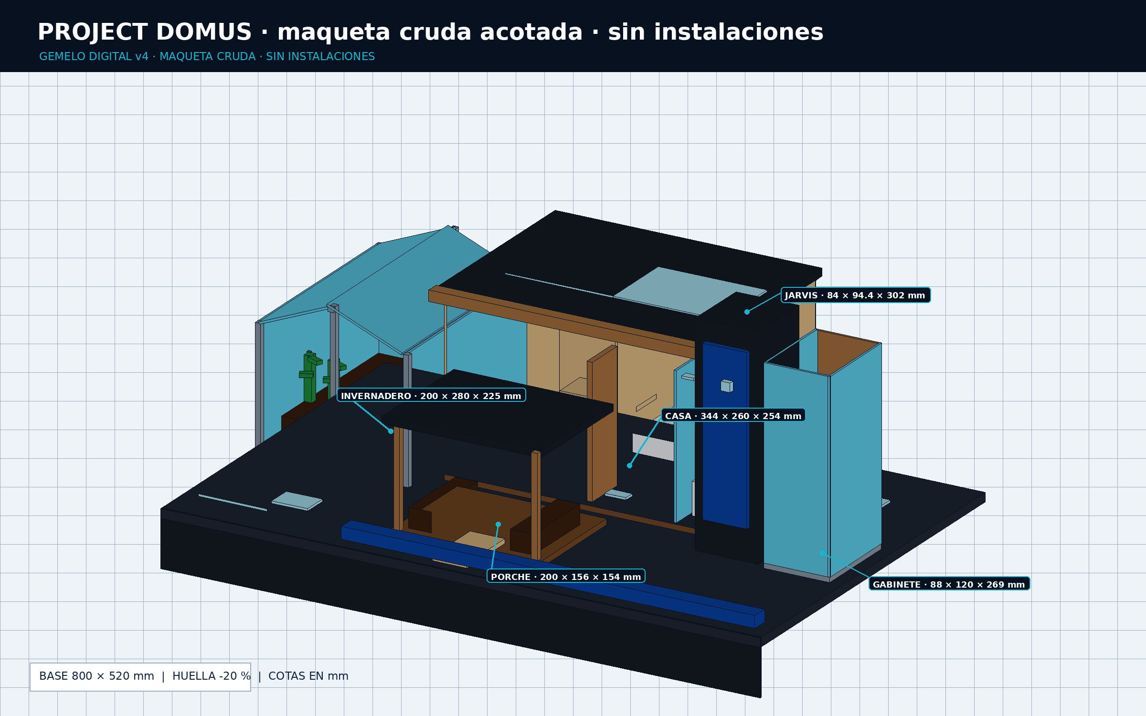
hardware/planos/project_domus_render.png
