gvayoy-web/DOMUS/hardware/planos/PROJECT_DOMUS_RENDER_FINAL_ALTA_RESOLUCION.png

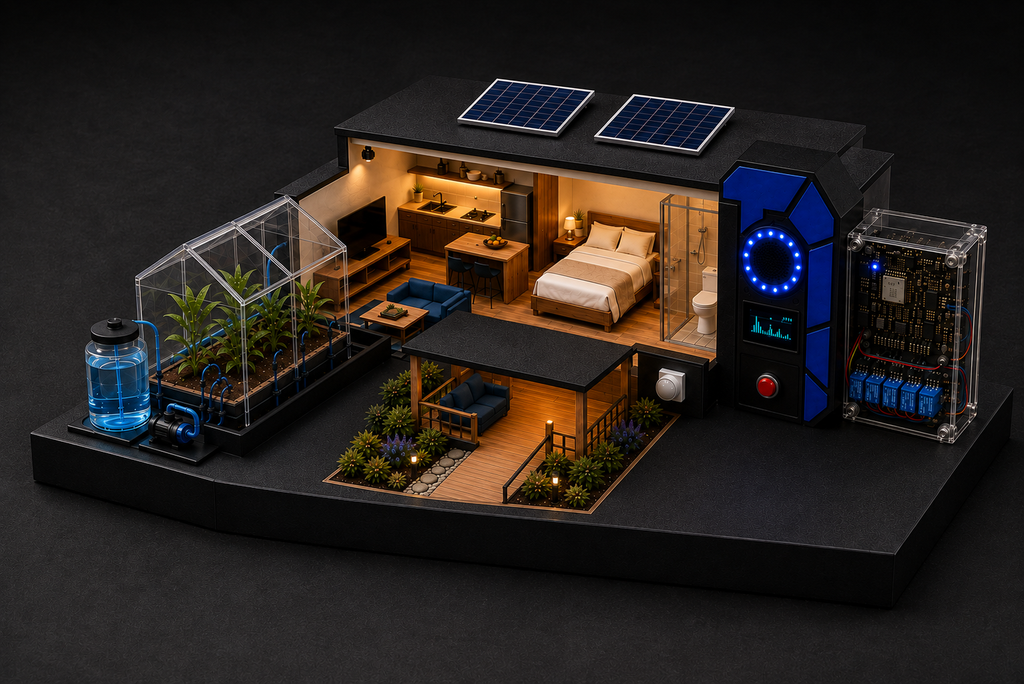
hardware/planos/PROJECT_DOMUS_RENDER_FINAL_ALTA_RESOLUCION.png
