gvayoy-web/DOMUS/hardware/planos/referencia_original.png

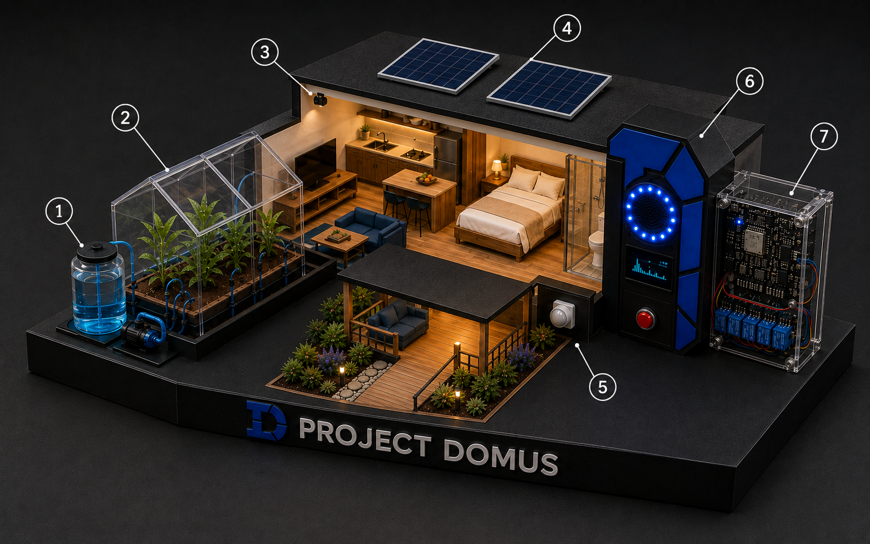
hardware/planos/referencia_original.png
