gvayoy-web/DOMUS/output/diagramas/guia-identificacion-transistor-diodo-led.png

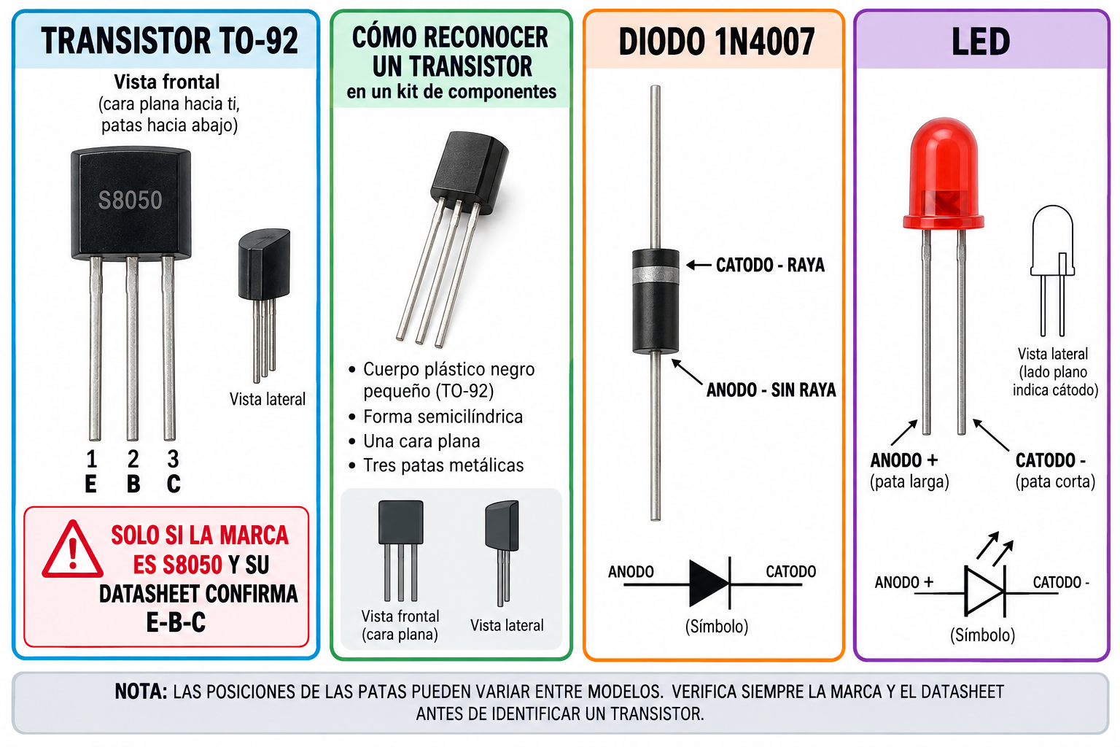
output/diagramas/guia-identificacion-transistor-diodo-led.png
