gvayoy-web/DOMUS/visualizaciones/domus-lcd-final-mockup.png

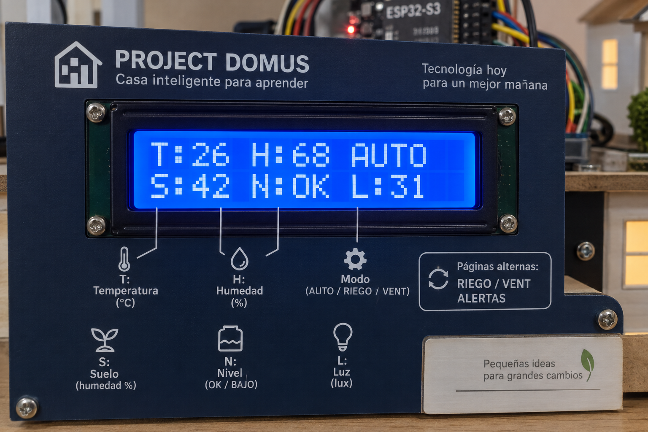
visualizaciones/domus-lcd-final-mockup.png
