gvayoy-web/DOMUS/obsidian/proyect domus/02 - Matriz funciones y componentes.md

---
proyecto: PROJECT DOMUS
tipo: matriz
actualizado: 2026-09-07
estado: historico
---

# Matriz de funciones y componentes

| Función prometida | Hardware necesario | ¿Está? | Trabajo pendiente |
|---|---|---|---|
| Control central | ESP32-S3 N16R8 | Sí | Cargar y validar firmware en placa real. |
| Pantalla de estado | LCD1602 + adaptador I2C | Sí | Código corregido a GPIO13 provisional y detección 0x27/0x3F; confirmar pin físicamente. |
| Luz sala | LED + 220/330 ohm | Disponible, no habilitado | GPIO5 reservado; requiere perfil LED futuro. |
| Luz dormitorio | LED + 220/330 ohm | Disponible, no habilitado | GPIO6 reservado; requiere perfil LED futuro. |
| Luz invernadero | LED + 220/330 ohm | Disponible, no habilitado | GPIO8 reservado; requiere perfil LED futuro. |
| Ventilación | Motor/aspa + S8050 + diodo | Disponible, no habilitado | GPIO7 reservado; diseñar después de aprobar bomba. |
| Riego | Bomba+tubo, relé, depósito | Sí/Parcial | Usar relé de 1 canal existente; falta depósito físico y prueba de fugas. |
| Humedad de suelo | Sonda resistiva | Sí | Código e histéresis completos; calibrar seco/húmedo físicamente. |
| Temperatura/humedad de aire | DHT11/DHT22 | Sí | Confirmar modelo real y calibrar. |
| Luz ambiental | LDR + 10 kΩ | Sí | Montar divisor y calibrar. |
| Presencia | PIR | Sí | Código y retención implementados; confirmar GPIO9 y nivel activo. |
| Nivel de depósito | Sensor de nivel | Sí | Lectura, validación y bloqueo de bomba implementados; confirmar GPIO2, umbral y protección contra agua. |
| Jarvis escucha | INMP441 | No | Comprar/importar y probar PoC a 16 kHz. |
| Jarvis entiende | modelos TinyML int8 | No, es software | Grabar dataset, entrenar, medir precisión y guardar en flash. |
| Jarvis habla | PicoTTS + MAX98357A + altavoz | Parcial | PoC existe; falta hardware e integración. |
| Aro azul | WS2812 + 330 Ω + desacoplo | Sí/Parcial | Tira y resistencia sí; adaptar nivel lógico es recomendado. |
| Respaldo de voz MP3 | DFPlayer + microSD + altavoz | Parcial | DFPlayer sí; tarjeta y salida de audio no. Es opcional. |
| Diagnóstico local | USB Serial del ESP32-S3 | Sí | Estado, diagnóstico, paro, rearme, recuperación y limitación de ráfagas implementados. |
| Supervisor anti-colapso | ESP32-S3 | Sí | Modo seguro por memoria/reinicios, watchdog y recuperación explícita implementados. |
| Wi-Fi/MQTT | ESP32-S3 + router | Fuera de alcance | No pertenece al núcleo local decidido; solo sería una extensión futura. |
| Solar y batería | Elementos de maqueta | Estética | Permanecen eléctricamente desconectados. |

## Recuento correcto de relés

El diseño tiene **cinco cargas conmutadas**:

1. Bomba.
2. Luz de sala.
3. Luz de dormitorio.
4. Ventilador.
5. Luz de invernadero.

Asignación operativa según inventario real:

| Hardware | GPIO/canal | Carga |
|---|---:|---|
| Relé de 1 canal que ya tienes | 1 | Bomba |
| Sin etapa física habilitada | GPIO5 | Luz sala futura con LED |
| Sin etapa física habilitada | GPIO6 | Luz dormitorio futura con LED |
| Sin etapa física habilitada | GPIO7 | Ventilador futuro con driver |
| Sin etapa física habilitada | GPIO8 | Luz invernadero futura con LED |

**Conclusión histórica:** se propuso comprar un módulo de cuatro relés compatible
con lógica de 3.3 V. La decisión vigente lo difiere: solo se monta el relé
desnudo de bomba y GPIO5-8 quedan bloqueados.

## Qué se mostrará aunque Jarvis aún no esté listo

La demostración mínima defendible funciona con LCD, DHT, LDR, humedad de suelo, bomba, ventilador, luces, botones/USB Serial y reglas locales. Jarvis se habilita únicamente después de validar micrófono, modelo y audio.
