gvayoy-web/DOMUS/documentos/Lista_de_Compras_y_Fallas_Reales_PROJECT_DOMUS.docx

AUDITORÍA TÉCNICA Y DE COMPRAS

PROJECT DOMUS

Lista de compras basada en el inventario real, el firmware actual y precios web en Honduras

Inventario base: Lista confirmada por Isaac el 1 de septiembre de 2026

Tiendas revisadas: C&D Tecnología y Steren Honduras

Destino: Maqueta escolar de baja tensión; envío a Choluteca por confirmar

Criterio: Comprar solo lo que desbloquea una función demostrable

VEREDICTO
Sí faltan piezas importantes. No hace falta otra pantalla, pero sí un lector microSD SPI dedicado si el ESP32 debe abrir archivos, configuraciones, registros o recursos directamente. La ranura del DFPlayer pertenece al reproductor y no funciona como almacenamiento general del ESP32. La compra mínima correcta es: fuente estable de 5 V/3 A, módulo de 4 relés, distribución/fusible/cableado y, si se presentará Jarvis hablando, INMP441 + MAX98357A + altavoz. El sistema solar debe comprarse después de medir consumo, no antes.

# Presupuesto rápido

Fase | Presupuesto | Qué entrega
Casa estable | hasta L1,020 | 5 cargas, alimentación y cableado de demostración
Jarvis local + almacenamiento | L528 + INMP441 | voz local y microSD accesible directamente por el ESP32
Respaldo portátil | L499 | power bank comercial 10,000 mAh; alternativa más segura a celdas sueltas
Solar 7,500 mAh | aprox. L1,355 | fase experimental; sin envío, montaje ni herramientas

Los precios son referencias visibles al 1 de septiembre de 2026. En productos con selector, el presupuesto usa la variante necesaria; debe reconfirmarse antes de pagar.

# 1. Fallas reales encontradas

IMPORTANTE
No todas las fallas se resuelven comprando. Las filas marcadas como software deben corregirse antes del cableado final.

Nivel | Hallazgo | Consecuencia | Acción real
CRÍTICA | GPIO22 usado como SCL | El ESP32-S3 solo tiene GPIO0–21 y GPIO26–48; el LCD I2C no funcionará así. | Cambiar pin y validar el pinout físico. No comprar otra pantalla.
ALTA | 8 relés en código; 1 físico | Cinco cargas planeadas no pueden conmutarse con un solo canal. | Comprar 1 módulo de 4 canales y usarlo junto al relé existente.
ALTA | Sin barra de 5 V estable | Bomba, ventilador, relés, audio y LEDs pueden reiniciar el ESP32 por caídas. | Fuente 5 V/3 A, fusible, cable 22 AWG, conectores y capacitores.
ALTA | Jarvis no tiene oído ni voz física | El firmware principal todavía no puede escuchar ni hablar. | INMP441, MAX98357A y altavoz; luego integrar y probar modelos.
ALTA | Sin almacenamiento microSD del ESP32 | La tarjeta insertada en el DFPlayer solo puede usarse a través de sus órdenes de reproducción; el ESP32 no puede montarla como sistema de archivos. | Comprar lector SPI separado y una tarjeta FAT32. Reservar la ranura del DFPlayer para audio de respaldo.
ALTA | Consumo no medido | No se puede garantizar batería de 2 h ni tamaño de fusible solo con estimaciones. | Medir corriente promedio y pico con el multímetro que ya tienes.
MEDIA | Sensor de suelo mal descrito | El hardware confirmado es resistivo, no capacitivo; se corroe y calibra distinto. | No comprar para la primera demo; corregir texto/código y energizar solo al medir.
MEDIA | Sensor de viento inexistente | El motor con aspa es ventilador, no anemómetro calibrado. | Eliminar esa afirmación o comprar un sensor real solo si es requisito.
MEDIA | PIR y nivel de agua sin lógica | Los módulos existen, pero hoy no son funciones demostrables. | No comprar duplicados; asignar pines e integrar software.
MEDIA | GPIO19 reservado para USB D− | El pin del DFPlayer puede interferir si se usa USB nativo. | Reasignar UART antes de cerrar el arnés.
MEDIA | Sin adaptación WS2812 | 3.3 V puede funcionar de forma marginal con tira a 5 V. | 74AHCT125/74HCT14 recomendado; el 74HC595 no lo sustituye.
BAJA | Capacitor “104 pF” mal rotulado | 104 significa 100 nF = 0.1 µF, no 104 pF. | No comprar; corregir inventario y usarlo como desacoplo.

# 2. Lo que ya tienes — no duplicar

Área | Confirmado | Decisión
Control | ESP32-S3 N16R8, Pico, ESP8266 | El ESP32-S3 es el controlador principal; no comprar otra placa.
Pantalla | LCD1602 + adaptador I2C | Suficiente. Confirmar si el adaptador listado dos veces es realmente una o dos unidades.
Audio legado | DFPlayer Mini | Su ranura microSD sirve para las pistas del propio reproductor; no sustituye un lector conectado al ESP32.
Conmutación | 1 relé de un canal | Conservarlo; completa cinco cargas junto a un módulo de cuatro canales.
Carga USB | 2 TP4056 USB-C con protección | No recomprar. Úsalos solo en una arquitectura USB 1S separada.
Sensores | DHT, PIR, HC-SR04, LDR, suelo resistivo, nivel de agua, Reed, RFID | Hay hardware suficiente; varias funciones faltan por código, no por compras.
Actuadores | Bomba, motor/ventilador, servo, LEDs y WS2812 | No comprar duplicados hasta medir consumo y probar cada carga.
Instrumentación | Multímetro | Es la herramienta clave para cerrar batería, fusible y fuente.
Cableado | M/M y H/M | Falta confirmar H/H o decidir soldadura/conectores para el montaje final.

## Tres dudas ya resueltas

Pantalla: usa el LCD1602 I2C que ya tienes. El soporte OLED del código no crea una necesidad de compra.

microSD: hacen falta un lector SPI separado y una tarjeta para que el ESP32 monte un sistema de archivos. La ranura del DFPlayer solo almacena sus pistas. TinyML puede seguir en la flash del ESP32; la microSD se reserva para datos, configuraciones, registros y recursos que el firmware necesite abrir.

Relés: compra cuatro canales, no ocho. La maqueta define cinco cargas y ya posees un relé de un canal.

# 3. Lista de compras obligatoria — casa estable

ORDEN RECOMENDADO
Compra esta fase antes de Jarvis y antes del sistema solar. Es la que evita reinicios, cables sobrecargados y funciones que no se pueden demostrar.

Producto | Cant. | Precio | Por qué / condición
Fuente 5 V/3 A USB-C con switch | 1 | L350 presup. | La página muestra desde L248; elegir y confirmar exactamente la variante USB-C 5 V/3 A con interruptor.
Módulo relé 4 canales 5 V/10 A | 1 | L250 presup. | Entrada TTL 3.3/5 V, optoacoplado y activo en LOW; completa las cinco cargas.
Portafusible aéreo 5×20 mm | 1 | L15 | Instalar en la rama principal de 5 V, accesible para reemplazo.
Fusible 3 A 5×20 mm | 3 | L45 | Uno en uso y dos repuestos. El valor final se confirma al medir picos.
Capacitores 1000 µF/25 V, paquete de 5 | 1 | L35 | Uno en barra principal; otros cerca de audio y cargas con motor.
Conectores PCT, paquete de 4 | 1 | L40 | Derivación desmontable de 5 V y GND; evita empalmes retorcidos.
Cable cobre flexible 22 AWG | 1 lote | desde L35 | Alimentación de cargas. No usar jumpers largos para bomba, ventilador o barra principal.
Jumpers H/H | 1 faja | hasta L250 | Comprar solo H/H si hay variante; el set C&D trae H/H, H/M y M/M.

Subtotal mínimo conocido sin H/H ni cable: L735. Subtotal conservador con cable y set completo de jumpers: hasta L1,020.

CONEXIÓN CORRECTA
La fuente USB-C puede alimentar el ESP32 por su puerto, pero las cargas necesitan una derivación de 5 V propia y GND común. No hagas circular la corriente de bomba, relés y altavoz por el pin de 3.3 V ni por pistas finas del ESP32.

## Herramientas y acabado eléctrico

Compra si no existe | Precio visto | Uso
Termocontráctil, set 127 piezas | L150 | Aislar soldaduras y cables de la alimentación.
Estaño 0.8 mm 63/37, 22 ft | L190 | Montaje final sobre placa o conexiones soldadas.
Baquelita PCB soldable 7×9 cm | L80 | Opcional: más robusta que protoboard para exposición.

# 4. Compras para Jarvis local

LÍMITE HONESTO
Jarvis será un asistente local de órdenes limitadas: palabra de activación, clasificación de intención y respuestas habladas. No será un LLM conversacional tipo Iron Man.

Producto | Cant. | Prioridad | Precio | Uso real
INMP441 I2S | 1 | Obligatorio | Sin precio hondureño verificable | Micrófono digital; alimentar a 3.3 V. No sustituir por KY-037/KY-038.
MAX98357A | 1 | Obligatorio | C&D L130 | DAC/amplificador I2S; 2.7–5.5 V y hasta ~3 W en 4 Ω.
Altavoz 4 Ω/3 W | 1 | Obligatorio | C&D L90 | Salida hablada; conectar a SPK+ y SPK− del amplificador.
74AHCT125 o 74HCT14 | 1 | Recomendado | Importación / consultar | Nivel lógico estable para WS2812 a 5 V.
Lector/escritor microSD SPI | 1 | Obligatorio | C&D L149 | Almacenamiento montable por el ESP32. Módulo con SPI y adaptación 3.3/5 V.
microSD 4 GB FAT32 | 1 | Obligatorio | Usar 32 GB Steren L159 si no hay 4 GB | Para archivos del ESP32. 2 GB basta, pero 4 GB FAT32 es preferible; 8–32 GB FAT32 también sirve.
Segunda microSD FAT32 | 1 | Opcional | Steren L159 | Solo si también se usará el DFPlayer como respaldo MP3. Una tarjeta no se comparte entre ambos módulos.

Subtotal de voz y almacenamiento verificable: L528 + precio del INMP441 (MAX98357A, altavoz, lector SPI y una microSD local de 32 GB como sustituta disponible de la tarjeta de 4 GB). Con una segunda tarjeta para el DFPlayer: L687 + INMP441.

DOS RANURAS, DOS FUNCIONES
Lector SPI + tarjeta 1: archivos que abre el ESP32. DFPlayer + tarjeta 2: pistas MP3/WAV que reproduce el DFPlayer. No conectes una misma tarjeta simultáneamente a los dos módulos.

No se encontró una oferta local verificable de un módulo INMP441 en C&D o Steren Honduras. Mouser Honduras muestra una placa oficial de evaluación mucho más cara y sin existencias; para este proyecto conviene buscar el módulo maker INMP441 y confirmar vendedor/envío antes de pagar.

## Lo que falta aunque compres el hardware

- Grabar un dataset español real con ruido de aula y varias voces.
- Entrenar y validar el detector de “Jarvis” y el clasificador de intenciones int8.
- Integrar PicoTTS con MAX98357A en el firmware principal.
- Definir un mapa de pines que no choque con I2C, USB, relés ni sensores.
- Probar diez veces seguidas cada orden y mantener desactivado JARVIS_LOCAL_HABILITADO hasta aprobar.

# 5. Energía portátil y solar

RECOMENDACIÓN PARA LA FERIA
Para dos horas de demostración, primero mide el consumo. Si quieres movilidad sin fabricar un pack de litio, una power bank comercial de 10,000 mAh y salida 5 V/3 A es la opción más segura y económica encontrada.

Opción | Precio | Ventaja | Advertencia
Steren MOV-1000, 10,000 mAh | L499.01 | Protecciones integradas y salida USB hasta 3 A | Confirmar que no se apague por baja carga y medir autonomía real.
Pack 1S3P + solar | aprox. L1,355 | Demuestra carga solar y almacenamiento | Requiere celdas nuevas, idénticas, igualadas y montaje supervisado.

## Compra solar condicional — 7,500 mAh nominales

Producto | Cant. | Subtotal | Condición técnica
Panel 5 V/1,100 mA | 1 | L280 | Debe entregar al menos 4.4 V al CN3065; medir a pleno sol.
18650 BAK 2,500 mAh | 3 | L540 | Solo nuevas, mismo lote, misma tensión; no mezclar recicladas.
Portacelda 18650 | 3 | L165 | Evita soldar directamente sobre las celdas.
BMS 1S | 1 | L85 | Una sola protección del pack; no apilar varias placas de protección.
CN3065 solar | 1 | L135 | Cargador 1S; el IC requiere entrada 4.4–6 V.
MT3608 | 1 | L90 | Eleva 3–4.2 V a 5 V; ajustar con multímetro antes de conectar ESP32.
Interruptor KCD1 | 1 | L25 | Corte general de baja tensión.
Capacitor 6,800 µF/25 V | 1 | L35 | Ayuda con picos; no reemplaza una fuente o convertidor insuficiente.

Subtotal solar estimado: L1,355, sin fusible, cableado, envío ni mano de obra.

NO MEZCLAR CARGADORES
USB: batería 1S → un TP4056 protegido → elevador. Solar: panel → CN3065 → pack 1S → un BMS → fusible/switch → elevador. No conectes TP4056 + CN3065 + otro BMS en serie “por más protección”.

Un panel de 3 V/110 mA no sirve para esta arquitectura: entrega solo 0.33 W y está por debajo de la entrada mínima de 4.4 V del CN3065. El panel de 5 V/1,100 mA también debe medirse, porque la ficha comercial contiene datos de potencia inconsistentes.

# 6. Materiales físicos que todavía faltan confirmar

Estos artículos no aparecen en el inventario confirmado. Sus precios varían demasiado por tamaño y tienda; se incluyen como lista de compra local sin inventar un total.

Zona | Comprar / conseguir | Criterio
Base | Plywood 6–9 mm o cartón corrugado doble | Rigidez suficiente para casa, invernadero y panel frontal.
Muros/techo | Cartón reciclado, foamboard o plywood delgado | Elegir un solo sistema estructural y reforzar esquinas.
Invernadero | Acrílico/PET transparente reciclado | Cubierta visible y resistente a salpicaduras.
Agua | Depósito cerrado + bandeja de contención | Evitar fugas sobre electrónica y mesa de exposición.
Montaje | Separadores M3, tornillos, tuercas, bridas | Ninguna placa debe quedar suelta o apoyada sobre metal.
Adhesivos | Silicón caliente, pegamento para madera, cinta doble cara | Fijación mecánica; no usar silicón sobre conectores que deban repararse.
Acabado | Pintura negra, azul, tono madera y sellador | Identidad visual PROJECT DOMUS.
Etiquetas | Papel adhesivo o cartulina | Nombrar sensores, entradas, salidas y riesgos.

# 7. No comprar todavía

No comprar | Razón
OLED | El LCD1602 I2C ya cubre la interfaz visual.
Un segundo lector SPI | Solo hace falta uno conectado al ESP32; la ranura integrada del DFPlayer ya cubre el audio de respaldo.
Relé de 8 canales | Cinco cargas = relé actual de 1 canal + nuevo módulo de 4 canales.
Otra placa ESP32 | La N16R8 tiene flash/PSRAM suficiente para la arquitectura prevista.
Otro TP4056 | Ya tienes dos y solo debe usarse uno por arquitectura USB 1S.
Baterías recicladas mezcladas | Capacidad, resistencia interna y estado desconocidos elevan el riesgo.
Panel de 3 V/110 mA | No llega al mínimo de entrada del CN3065 y su potencia es insuficiente.
Capacitor enorme como “solución” | 4,700–6,800 µF ayuda a picos, pero no corrige fuente débil ni mal cableado.
KY-037/KY-038 como sustituto del INMP441 | Son módulos analógicos de sonido y no reemplazan un micrófono I2S para voz.

# 8. Orden de compra y pruebas

Paso | Acción | Criterio de salida
1 | Corregir pinout | Cambiar GPIO22 y definir pines reales para cinco relés, PIR, agua y audio.
2 | Medir cargas | Bomba, ventilador, relés, WS2812 y audio: corriente en reposo, promedio y pico.
3 | Comprar fase estable | Fuente, 4 relés, fusible, capacitores, cable y conectores.
4 | Montar por bloques | Primero ESP32+LCD; luego relés; después motores; por último audio.
5 | Comprar Jarvis | Solo cuando el sistema base pase diez ciclos sin reinicios.
6 | Decidir autonomía | Power bank comercial para feria o solar experimental según mediciones.
7 | Cerrar maqueta | Después de probar, etiquetar y dejar acceso a fusible, switch y USB.

## Checklist antes de pagar

- Confirmar físicamente el modelo exacto y la serigrafía del ESP32-S3.
- Enviar a C&D una foto o enlace de la variante: relé 4 canales 5 V/10 A y fuente USB-C 5 V/3 A con switch.
- Preguntar existencia, costo y tiempo de envío a Choluteca.
- No comprar INMP441 si el vendedor no confirma que es salida digital I2S y alimentación de 3.3 V.
- Comprar un lector microSD SPI para el ESP32; confirmar que el módulo acepte lógica de 3.3 V y tarjetas FAT16/FAT32.
- Comprar una tarjeta para el lector del ESP32. Si se activará también el DFPlayer, presupuestar una segunda tarjeta independiente.
- No comprar celdas para un pack paralelo sin supervisión y sin medir que tengan igual tensión.
- Guardar comprobantes y anotar precio real para actualizar el presupuesto final.

## Aceptación técnica mínima

LA MAQUETA ESTÁ LISTA
Cuando arranca diez veces sin reinicio, activa cada una de las cinco cargas, muestra sensores coherentes en el LCD, corta la bomba por tiempo máximo y mantiene un método manual de respaldo si la voz falla.

# 9. Fuentes consultadas

Enlaces consultados el 1 de septiembre de 2026. Los precios no incluyen envío y pueden cambiar. Las especificaciones técnicas se contrastaron con documentación del fabricante cuando fue posible.

Espressif — GPIO del ESP32-S3: abrir fuente (https://docs.espressif.com/projects/esp-idf/en/v5.1/esp32s3/api-reference/peripherals/gpio.html) — Confirma GPIO0–21 y GPIO26–48; no existe GPIO22.

Espressif — DevKitC-1 v1.0: abrir fuente (https://docs.espressif.com/projects/esp-dev-kits/en/latest/esp32s3/esp32-s3-devkitc-1/user_guide_v1.0.html) — Pinout y funciones USB D−/D+ en GPIO19/20.

C&D — fuente 5 V/3 A: abrir fuente (https://sps.cdtechnologia.net/2985-fuente-para-raspberry-pi3-pi4.html) — Página con variantes micro-USB/USB-C y switch; confirmar precio de variante.

C&D — relés 1–8 canales: abrir fuente (https://sps.cdtechnologia.net/2719-865-modulo-rele-5-24v-10a-1-8-canales.html) — Incluye variante 4 canales 5 V, TTL 3.3/5 V, optoacoplada y activa en LOW.

C&D — MAX98357A: abrir fuente (https://sps.cdtechnologia.net/5855-modulo-amplificador-de-audio-i2s-max98357.html) — L130; audio I2S, 2.7–5.5 V, salida para 4 Ω.

C&D — parlante 4 Ω/3 W: abrir fuente (https://sps.cdtechnologia.net/4094-parlante-4ohm-3w.html) — L90.

C&D — portafusible: abrir fuente (https://sps.cdtechnologia.net/3685-portafusible-con-cable.html) — L15; 5×20 mm, cable 18 AWG.

C&D — capacitores: abrir fuente (https://sps.cdtechnologia.net/179-capacitores-electroliticos-1-valor-01-1000uf-5-unidades.html) — Paquete de cinco por L35; elegir 1000 µF.

C&D — conectores PCT: abrir fuente (https://sps.cdtechnologia.net/2623-conector-de-cable-pct-2-pines-5-pines-4-unidades.html) — Cuatro unidades por L40.

C&D — jumpers Dupont: abrir fuente (https://sps.cdtechnologia.net/118-1331-jumpers-de-conexion-dunpont-hh-mm-mh-40-hilos-20cm.html) — Selector H/H, H/M y M/M; set mostrado L250.

C&D — termocontráctil: abrir fuente (https://sps.cdtechnologia.net/productos-rebajados?page=10) — Set de 127 piezas visto a L150.

Steren — power bank MOV-1000: abrir fuente (https://www.steren.com.hn/power-bank-de-10-000-mah-con-turbo-charge-qc-y-power-delivery-con-2-salidas-usb-y-usb-c.html) — 10,000 mAh, salida USB hasta 3 A, L499.01.

Steren — microSD 32 GB: abrir fuente (https://www.steren.com.hn/memoria-microsd-hc-de-32-gb-clase-uhs-iu1-v10-a1-con-adaptador-sd.html) — L159; alternativa FAT32 disponible cuando no se encuentra una tarjeta de 4 GB.

C&D — lector/escritor microSD SPI: abrir fuente (https://sps.cdtechnologia.net/509-modulo-lector-y-escritor-de-tarjetas-micro-sd-compatible-con-arduino.html) — L149; SPI, adaptación 3.3/5 V, microSD hasta 2 GB y microSDHC hasta 32 GB.

DFRobot — DFPlayer Mini: abrir fuente (https://wiki.dfrobot.com/dfr0299) — La tarjeta del DFPlayer almacena las pistas y se controla mediante órdenes UART; no expone un sistema de archivos general al ESP32.

Espressif — SD por SPI: abrir fuente (https://docs.espressif.com/projects/esp-idf/en/v5.0.3/esp32s3/api-reference/peripherals/sdspi_share.html) — El ESP32-S3 monta una tarjeta conectada directamente por SPI mediante FAT/VFS.

C&D — panel 3–5.5 V: abrir fuente (https://sps.cdtechnologia.net/4506-panel-solar-3v-55v.html) — Seleccionar 5 V/1,100 mA y verificar datos con multímetro.

C&D — CN3065: abrir fuente (https://sps.cdtechnologia.net/4804-modulo-de-carga-baterias-de-litio-cn3065.html) — Módulo de carga solar 1S, L135.

CONSONANCE — CN3065 datasheet: abrir fuente (https://files.seeedstudio.com/wiki/Solar_Charger_Shield_V2.2/res/DSE-CN3065.pdf) — Rango de entrada 4.4–6 V y regulación de batería 4.2 V.

Adafruit — nivel lógico NeoPixel: abrir fuente (https://learn.adafruit.com/neopixel-levelshifter) — Recomienda 74AHCT125 para traducir 3.3 V a 5 V.

# 10. Conclusión de compra

COMPRA CORRECTA HOY
Fase estable (hasta L1,020) + MAX98357A, altavoz, lector microSD SPI y una tarjeta (L528 usando la microSD de 32 GB disponible). El INMP441 se compra solo con vendedor confirmado. OLED y relé de 8 canales no son necesarios. Si se activa también el DFPlayer, hace falta una segunda tarjeta. Para autonomía, prioriza la power bank comercial de L499.01; deja el pack solar para después de medir.

Documento generado a partir del inventario confirmado, la revisión del firmware y fuentes web. No sustituye la supervisión adulta al trabajar con baterías de litio, soldadura o herramientas.

Lista verificada • 1 septiembre 2026 | Página 1

PROJECT DOMUS | Auditoría de compras
