gvayoy-web/DOMUS/assets/new/deliverables/execute/01_FINAL_V2/design/project_domus.obj

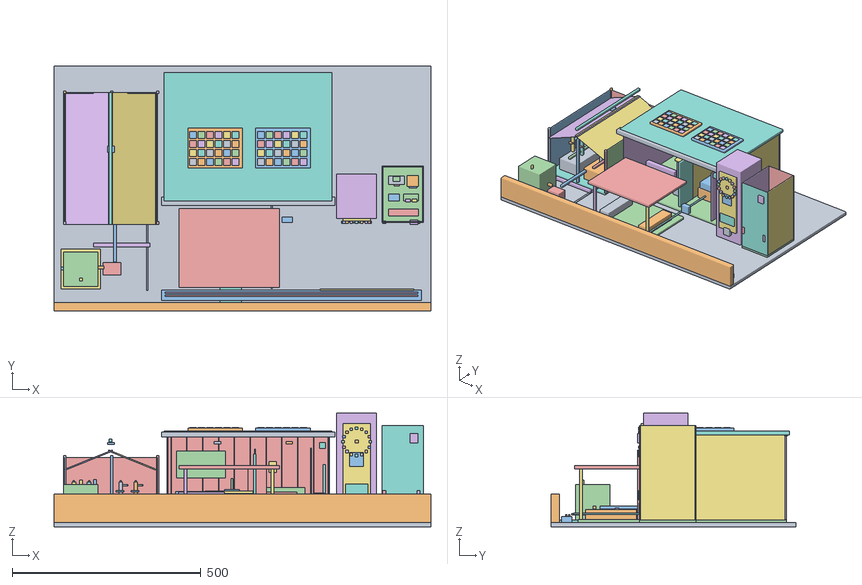
[picture p50: CAD file, 2026-09-03]
assets/new/deliverables/execute/01_FINAL_V2/design/project_domus.obj
1000.0 x 650.0 x 302.0
Base_negra_1000x650
Frente_rotulado_PROJECT_DOMUS
Canal_técnico_oculto
Piso_vivienda
Muro_posterior_vivienda
Muro_lateral_izquierdo
Muro_lateral_derecho
Techo_plano_removible
Alero_frontal
Mueble_bajo_cocina
Encimera_cocina
Gabinete_alto_cocina
Refrigerador
Isla_cocina
Cubierta_isla
Sofá_sala
Mesa_sala
Cama_base
Colchón
Cabecero
Mesa_de_noche
Mampara_baño
Ducha_piso
Lavamanos
Inodoro
Panel_solar_izquierdo
Panel_solar_derecho
Plataforma_porche
Cubierta_porche
Poste_porche_izquierdo
Poste_porche_derecho
Pasarela
Jardinera_izquierda
Jardinera_derecha
PIR_entrada
Depósito_de_agua
Mini_bomba_5V
Tubería_a_invernadero
Sensor_nivel_depósito
Base_invernadero
Bancal_izquierdo
Bancal_derecho
Panel_transparente_izquierdo
Panel_transparente_derecho
Panel_transparente_posterior
Cubierta_inclinada_izquierda
Cubierta_inclinada_derecha
Viga_cumbrera
Poste_invernadero_25-230
Poste_invernadero_25-577
Poste_invernadero_150-230
Poste_invernadero_150-577
Poste_invernadero_272-230
Poste_invernadero_272-577
Planta_48
Planta_88
Planta_172
Planta_212
Sensor_humedad_suelo
Línea_de_riego_izquierda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
