gvayoy-web/DOMUS/hardware/project_domus.obj

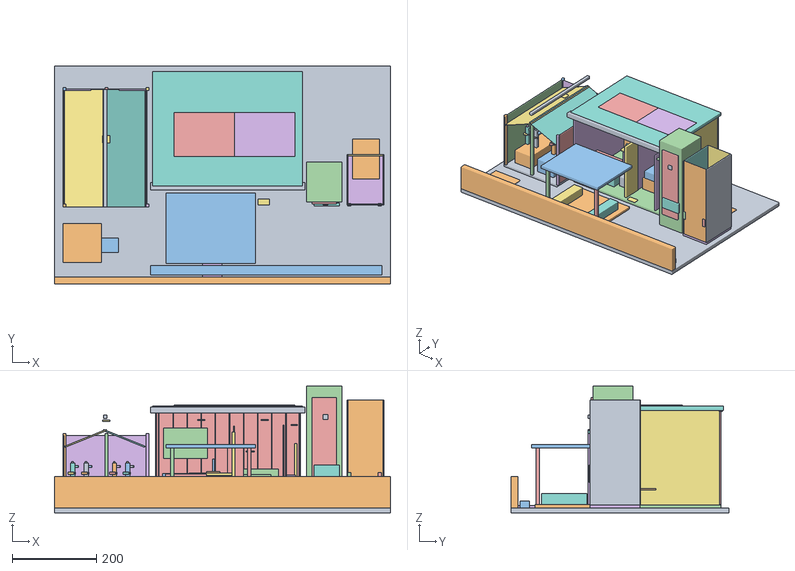
[picture p52: CAD file, 2026-09-04]
hardware/project_domus.obj
800.0 x 520.0 x 302.0
Base_negra_800x520
Frente_rotulado_PROJECT_DOMUS
Canal_técnico_oculto
Piso_vivienda
Muro_posterior_vivienda
Muro_lateral_izquierdo
Muro_lateral_derecho
Techo_plano_removible
Alero_frontal
Mueble_bajo_cocina
Encimera_cocina
Gabinete_alto_cocina
Refrigerador
Isla_cocina
Cubierta_isla
Sofá_sala
Mesa_sala
Cama_base
Colchón
Cabecero
Mesa_de_noche
Mampara_baño
Ducha_piso
Lavamanos
Inodoro
Plataforma_porche
Cubierta_porche
Poste_porche_izquierdo
Poste_porche_derecho
Pasarela
Jardinera_izquierda
Jardinera_derecha
Base_invernadero
Bancal_izquierdo
Bancal_derecho
Panel_transparente_izquierdo
Panel_transparente_derecho
Panel_transparente_posterior
Cubierta_inclinada_izquierda
Cubierta_inclinada_derecha
Viga_cumbrera
Poste_invernadero_25-230
Poste_invernadero_25-577
Poste_invernadero_150-230
Poste_invernadero_150-577
Poste_invernadero_272-230
Poste_invernadero_272-577
Planta_48
Planta_88
Planta_172
Planta_212
Torre_Jarvis_cuerpo
Panel_azul_central
Gabinete_técnico_base
Gabinete_fondo
Gabinete_lateral_izquierdo
Gabinete_lateral_derecho
Gabinete_frontal_removible
Junta_de_tablón_310
Junta_de_tablón_352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
