gvayoy-web/DOMUS/assets/new/deliverables/execute/02_HISTORIAL_V1/design/project_domus.obj

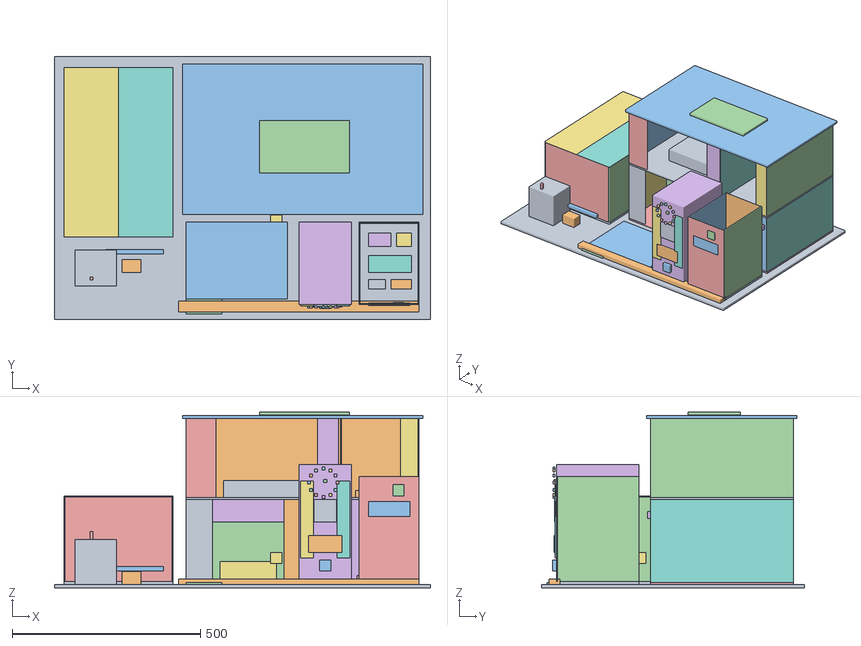
[picture p53: CAD file, 2026-09-02, an earlier design]
assets/new/deliverables/execute/02_HISTORIAL_V1/design/project_domus.obj
1000.0 x 700.0 x 468.0
Base_1000x700
Canal_principal_de_cables
Entrada_cubierta
Rampa_de_acceso
Piso_planta_baja
PB_muro_posterior
PB_muro_lateral_izquierdo
PB_muro_lateral_derecho
PB_frente_izquierdo
PB_frente_central
PB_frente_derecho
División_sala-cocina
Barra_cocina
Mueble_cocina
Sofá_sala
Mesa_sala
Entrepiso_removible
PA_muro_posterior
PA_muro_lateral_izquierdo
PA_muro_lateral_derecho
PA_frente_izquierdo
PA_frente_central
PA_frente_derecho
División_dormitorio-baño
Cama_dormitorio
Ducha
Techo_removible
Panel_solar_único
Escalón_1
Escalón_2
Escalón_3
Escalón_4
Escalón_5
Escalón_6
Escalón_7
Escalón_8
Escalón_9
Escalón_10
Escalón_11
Escalón_12
Invernadero_base
Cama_de_cultivo
Invernadero_pared_izquierda
Invernadero_pared_derecha
Invernadero_frente
Invernadero_fondo
Cubierta_invernadero_A
Cubierta_invernadero_B
Depósito_de_agua
Mini_bomba
Tubería_principal
Sensor_humedad_suelo
Sensor_nivel
Torre_Jarvis_cuerpo
Torre_panel_azul_izquierdo
Torre_panel_azul_derecho
Altavoz_frontal
LCD_estado
Botón_MIC_OFF
INMP441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
