gvayoy-web/DOMUS/hardware/planos/PLANOS_ULTIMATE_CONSTRUCCION_MAQUETA.pdf

PROJECT DOMUS - PLANOS ULTIMATE DE CONSTRUCCIÓN

# PLANOS ULTIMATE - CONSTRUCCIÓN DE LA MAQUETA

Documento exclusivo para cortar, perforar, ensamblar y terminar la estructura física

U-00 - PÁGINA 1/10 - REV ULTIMATE 1.0 - COTAS EN mm

QUÉ CONSTRUYE EL EQUIPO

- Base, faldón y tapas removibles.
- Casa abierta, mobiliario y tabiques.
- Porche, pasarela, jardineras e invernadero.
- Bancales/macetas con forros removibles.
- Carcasas vacías de Jarvis y gabinete.
- Pasamuros cerrados y marcas futuras.

QUÉ NO CONSTRUYE NI INSTALA

- No sensores, ESP32, relés o fuente.
- No cables, conectores ni soldaduras.
- No bomba, tubos ni depósito definitivo.
- No luces ni paneles solares reales.
- No abrir huecos de sensor sin medir la pieza.


## BASE FINAL: 800 × 520 mm - REDUCCIÓN UNIFORME AL 80 % DEL DISEÑO ORIGINAL

# IMPLANTACIÓN GENERAL Y EJES DE MONTAJE

Origen X0/Y0 en la esquina frontal izquierda; el faldón PROJECT DOMUS define el frente

U-01 - PÁGINA 2/10 - REV ULTIMATE 1.0 - COTAS EN mm

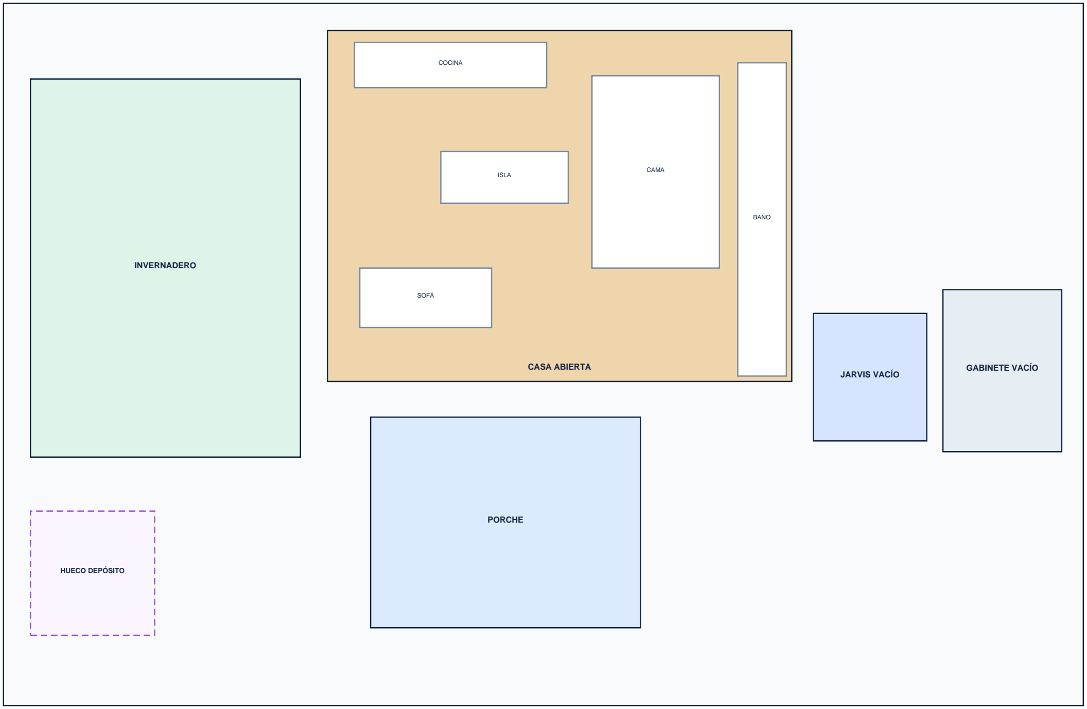
[picture p59: figure]
INVERNADERO; CASA ABIERTA; PORCHE; JARVIS VACÍO; GABINETE VACÍO; HUECO DEPÓSITO; COCINA; ISLA; SOFÁ; CAMA; BAÑO

800

520

FRENTE / VISITANTE

COORDENADAS

Invernadero: X20 / Y184

Casa: X240 / Y240

Porche: X272 / Y57.6

Jarvis: X600 / Y196

Gabinete: X696 / Y188

Depósito futuro: X20 / Y52

REGLAS

1. Marcar todo antes de pegar.
2. Presentar módulos en seco.
3. No recentrar ningún módulo.
4. Tolerancia de posición: ±0.5.
5. Sólido = pieza; punteado = hueco.

ALTURAS DE PROYECTO

Casa: Z superior 254

Invernadero: Z superior 225

Jarvis: Z superior 302

Gabinete: Z superior 269

# BASE, FALDÓN, CANAL VACÍO Y PASAMUROS

Todas las perforaciones de esta lámina son mecánicas; se entregan sin cables

U-02 - PÁGINA 3/10 - REV ULTIMATE 1.0 - COTAS EN mm

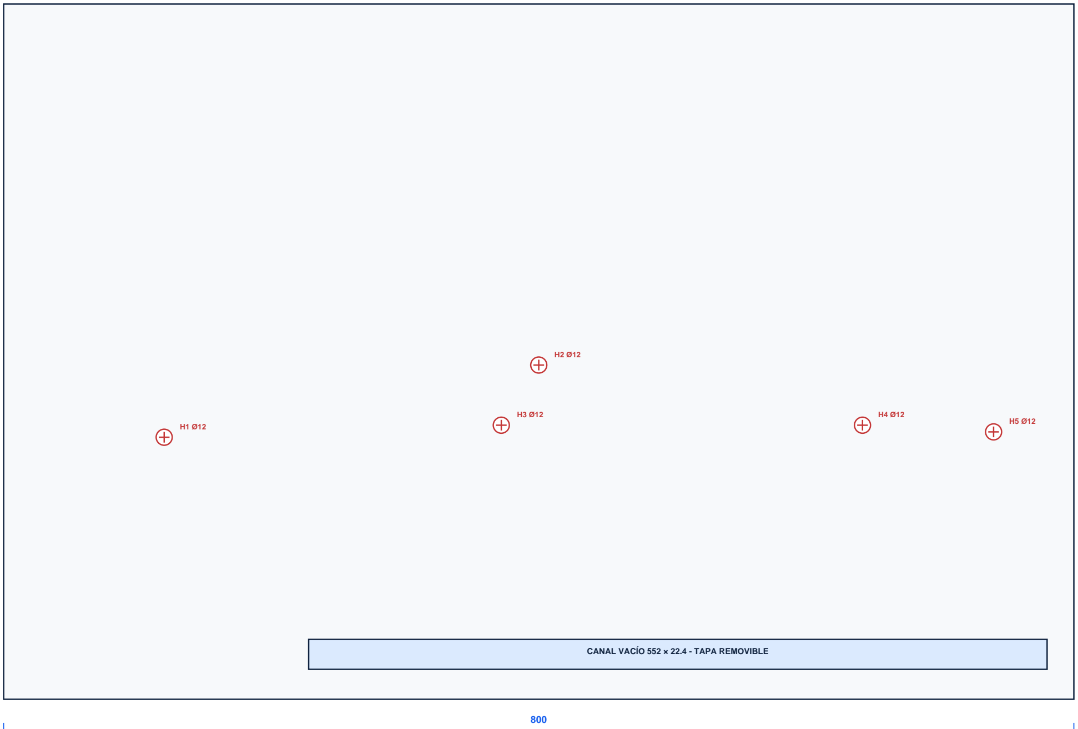
[picture p60: figure]
CANAL VACÍO 552 × 22.4 - TAPA REMOVIBLE

520

DESPIECE BASE

B-01 MDF 12: 800 × 520

B-02 Faldón 3: 800 × 75

B-03 Tapa canal 3: 552 × 22.4

Faldón: borde superior a Z12

Borde inferior a Z-63

Profundidad real del faldón: 3

PERFORACIÓN

H1-H5: Ø12 pasante.

Taladrar con madera apoyada.

Avellanar: NO.

Colocar tapón removible Ø12.

No introducir cable ni conector.

Desbarbar ambas caras.

ACABADO

Sellar MDF antes de pintar.

Negro mate; no pintar zonas de adhesión.

Comprobar planitud máxima 1 mm.

# CASA ABIERTA - PLANTA, MUROS Y TECHO

Huella 344 × 260; frente completamente abierto; altura interior 225

U-03 - PÁGINA 4/10 - REV ULTIMATE 1.0 - COTAS EN mm

COCINA

ISLA

SOFÁ

CAMA

BAÑO

FRENTE ABIERTO 344
344

260

HATCH 70 × 40

344

225

PIEZAS Y PERFORACIONES

Piso: 344 × 260 × 3 sobre bastidor 7 × 7.

Posterior: 344 × 225 × 3.

Laterales: 260 × 225 × 3 (2).

Techo removible: 356.8 × 272.8 × 3.

Hatch posterior: 70 × 40; reutilizar recorte.

4 alojamientos de imán Ø8 × 4 prof., a 8 de cada borde.

No abrir perforaciones de sensor en paredes.

# INTERIOR DE LA CASA - MOBILIARIO Y TABIQUES

Las piezas interiores son parte visual de la maqueta; pueden fabricarse como volúmenes huecos

U-04 - PÁGINA 5/10 - REV ULTIMATE 1.0 - COTAS EN mm

Código | Elemento | Cantidad | Medida exterior | Material / criterio
F-01 | Mueble bajo cocina | 1 | 142.4 × 33.6 × 68 | Plywood 3; caja hueca
F-02 | Encimera cocina | 1 | 147.2 × 38.4 × 7 | Madera 3 + separadores
F-03 | Refrigerador | 1 | 38.4 × 52.8 × 138 | Foamboard 3; volumen hueco
F-04 | Isla | 1 | 94.4 × 38.4 × 70 | Plywood 3; tapa 102.4 × 46.4
F-05 | Sofá | 1 | 97.6 × 44 × 52 | Foamboard + tela/EVA
F-06 | Mesa sala | 1 | 56 × 38.4 × 31 | Madera 2-3
F-07 | Cama | 1 | 94.4 × 142.4 × 61 | Base 37 + colchón 24
F-08 | Mesa de noche | 1 | 30.4 × 30.4 × 42 | Madera 2-3
F-09 | Baño esquemático | 1 | 36 × 232 de zona | Acrílico/blanco; sin tubería
F-10 | Tabique dormitorio | 1 | 182.4 × 188 × 3 | Plywood 3; removible

POSICIONES LOCALES DESDE CASA X0/Y0

Cocina: X20 / Y217.6

Isla: X84 / Y132

Sofá: X24 / Y40

Cama: X196 / Y84

Baño: X304 / Y4

Tabique: X185.6 / Y73.6

Puerta: ancho 57.6; alto 174

Mantener pasillo central mínimo 24.

CRITERIO DE CONSTRUCCIÓN

- Se permite simplificar tiradores y textiles.
- No cambiar huellas ni posiciones.
- Ningún mueble debe ocultar H-02.
- Baño decorativo: no conectar agua.
- Presentar en seco antes de fijar.
- Tolerancia de mobiliario: ±1 mm.

# PORCHE, PASARELA Y JARDINERAS

Plataforma 200 × 156; cubierta 212.8 × 168; cubierta inferior en Z154

U-05 - PÁGINA 6/10 - REV ULTIMATE 1.0 - COTAS EN mm

JARDINERA 30.4 × 108

JARDINERA 30.4 × 108

200

156

134 libre

JARDINERAS (2 UNIDADES)

Exterior: 30.4 × 108 × 26; PVC 2 mm.

Interior útil: 26.4 × 104 × 22.

Altura máxima de tierra: 18; dejar 4 libres.

Forro PET removible; no pegar al cajón.

Marcar 2 centros Ø3 en el forro, sin perforar aún.

Volumen de tierra recomendado: 45-50 mL cada una.

# INVERNADERO Y BANCALES PARA TIERRA

Huella 200 × 280; cumbrera Z225; paneles transparentes sin sensores ni tuberías

U-06 - PÁGINA 7/10 - REV ULTIMATE 1.0 - COTAS EN mm

200

206 al apoyo

CUMBRERA SUPERIOR Z225

PASILLO 24.8

200

280

DESPIECE

Base: 200 × 280 × 3

Laterales: 280 × 165 × 1.5 (2)

Posterior: 200 × 165 × 1.5

Techo: 280 × 108.1 × 1.5 (2)

Pendiente: 22.3°

Postes ext.: 7 × 7 × 165 (4)

Postes cumbrera: 7 × 7 × 206 (2)

Viga: 8 × 8 × 280

BANCAL / MACETA (2)

Exterior: 60.8 × 224 × 42

Pared/fondo: PVC 2

Interior: 56.8 × 220 × 38

Tierra máxima: 30 de alto

Volumen aprox.: 0.375 L cada uno

Inserto removible: 16 × 16

Marcar Ø8 para futura sonda

No perforar hasta medir sensor

# CARCASAS VACÍAS: JARVIS Y GABINETE

Se construyen y entregan sin pantalla, placa, relés, altavoz, cables ni perforaciones definitivas

U-07 - PÁGINA 8/10 - REV ULTIMATE 1.0 - COTAS EN mm

PANTALLA

ALTAVOZ

BOTÓN

84

290

JARVIS - DESPIECE

Frente/fondo: 84 × 290 × 3 (2)

Laterales: 88.4 × 290 × 3 (2)

Tapa y base interior: 78 × 88.4 × 3 (2)

Panel azul decorativo: 58.4 × 220 × 1.5

Frente fijado con 4 tornillos M2 o imanes.

Contornos morados: grabar/marcar 0.3 prof.

NO cortar pantalla, micrófono, altavoz o botón.

Altura de proyecto desde Z0: 302.

88

250

GABINETE - DESPIECE

Base: 88 × 120 × 7

Fondo: 88 × 250 × 3

Laterales: 120 × 250 × 3 (2)

Frente removible: 88 × 250 × 3

Interior útil aprox.: 82 × 114 × 244

No instalar bandeja electrónica.

No taladrar ventilación todavía.

Dejar 4 puntos de fijación M2 marcados.

Altura de proyecto desde Z0: 269.

REGLA DE ENTREGA

Las dos carcasas deben abrirse sin herramientas especiales y quedar completamente vacías.

Las marcas moradas no son agujeros: indican zonas sacrificables para la integración posterior.

Proteger el acrílico durante el armado y retirar la película solo al final.

# PERFORACIONES, INSERTOS Y PIEZAS REMOVIBLES

Diferenciar claramente: TALADRAR AHORA, MARCAR SOLAMENTE y NO PERFORAR

U-08 - PÁGINA 9/10 - REV ULTIMATE 1.0 - COTAS EN mm

ID | Ubicación | Centro / referencia | Acción | Entrega
H-01 | Base bajo invernadero | X 120 / Y 196 | Ø12 pasante | Colocar tapón; sin cable
H-02 | Base bajo casa | X 400 / Y 250 | Ø12 pasante | Colocar tapón; sin cable
H-03 | Base bajo porche | X 372 / Y 205 | Ø12 pasante | Colocar tapón; sin cable
H-04 | Base bajo Jarvis | X 642 / Y 205 | Ø12 pasante | Colocar tapón; sin cable
H-05 | Base bajo gabinete | X 740 / Y 200 | Ø12 pasante | Colocar tapón; sin cable
H-06 | Techo casa, 4 esquinas | A 8 mm de cada borde | Ø8 × 4 prof. | Alojamiento de imanes
H-07 | Hatch muro posterior | Centrado; borde inf. 15 | 70 × 40 | Recorte reutilizado como tapa
H-08 | Insertos de bancal | Local 30 / 112 | 16 × 16 removible | Marcar Ø8; no abrir hasta medir sonda

TALADRAR AHORA

- H-01 a H-05: Ø12 pasante.
- H-06: alojamientos Ø8 × 4 prof.
- H-07: hatch 70 × 40.
- Desbarbar, sellar y probar tapas.
- Entregar H-01 a H-05 con tapón.
- No pasar ningún cable.

MARCAR SOLAMENTE

- Ø8 en insertos de bancales.
- Zonas de pantalla/micrófono/altavoz.
- Puntos M2 del gabinete.
- Centros de drenaje Ø3 en forros.
- Usar línea fina morada o grabado suave.

NO PERFORAR

Paneles transparentes del invernadero, muebles, baño ni fachadas visibles.

Toda apertura variable se confirma con el componente físico.

# MATERIALES, LISTA DE CORTE Y CONTROL DE CALIDAD

Comprar por espesor; verificar el calibre real con pie de rey antes de cortar

U-09 - PÁGINA 10/10 - REV ULTIMATE 1.0 - COTAS EN mm

ID | Material | Espesor/sección | Cantidad | Uso
M-01 | MDF | 12 mm | 1 pieza 800 × 520 | Base estructural
M-02 | Plywood/MDF | 3 mm | 2 láminas 600 × 900 aprox. | Casa, cubiertas, pisos y faldón
M-03 | Acrílico transparente | 1.5 mm | 1 lámina 600 × 900 | Invernadero
M-04 | Acrílico transparente | 3 mm | 1 lámina 300 × 450 | Gabinete y tapas removibles
M-05 | Listón cuadrado | 7 × 7 mm | 2.5 m | Bastidores e invernadero
M-06 | Listón cuadrado | 8 × 8 mm | 1.2 m | Porche y cumbrera
M-07 | PVC espumado | 2 mm | 1 lámina A3 | Bancales y jardineras
M-08 | PET/acetato flexible | 0.5 mm | 4 recortes | Forros impermeables removibles
M-09 | Imán neodimio | Ø8 × 4 mm | 4 pares | Techo removible de la casa
M-10 | Pasamuros/tapón | Ø12 mm | 5 unidades | Accesos futuros, entregados cerrados
M-11 | Adhesivo PVA + cemento acrílico | - | Según consumo | Uniones estructurales
M-12 | Pintura/sellador | - | Negro mate + protector | Base, cantos y madera

CONTROL DE CALIDAD ANTES DE ENTREGAR

■ Base 800 × 520, plana y escuadrada.

■ Módulos en las coordenadas U-01.

■ Casa de una planta y frente abierto.

■ Techo, hatch y frentes removibles.

■ Bancales y jardineras con forro removible.

■ Invernadero sin grietas ni tensión.

■ H-01 a H-05 cerrados con tapones.

■ Marcas futuras visibles pero sin cortar.

■ Jarvis y gabinete completamente vacíos.

■ Sin sensores, cables, bomba o conexiones.

ARCHIVOS COMPLEMENTARIOS

Lista de corte completa: lista_corte_ultimate.csv

Perforaciones: perforaciones_y_accesos.csv

Materiales: materiales_ultimate.csv

TOLERANCIAS

Corte estructural ±0.5 - Mobiliario ±1.0 - Perforaciones ±0.3 - Escuadra máxima 0.5 por 300 - Planitud base máxima 1.0

Orden obligatorio: marcar → presentar en seco → perforar → sellar cantos → pegar → probar removibles → pintar → inspeccionar.
