gvayoy-web/DOMUS/assets/new/deliverables/execute/02_HISTORIAL_V1/design/plano_tecnico_domus.pdf

# PROJECT DOMUS · PLANO TÉCNICO ACOTADO

### Maqueta de dos pisos · sistema 100 % local · cotas en milímetros · escala gráfica 1:10

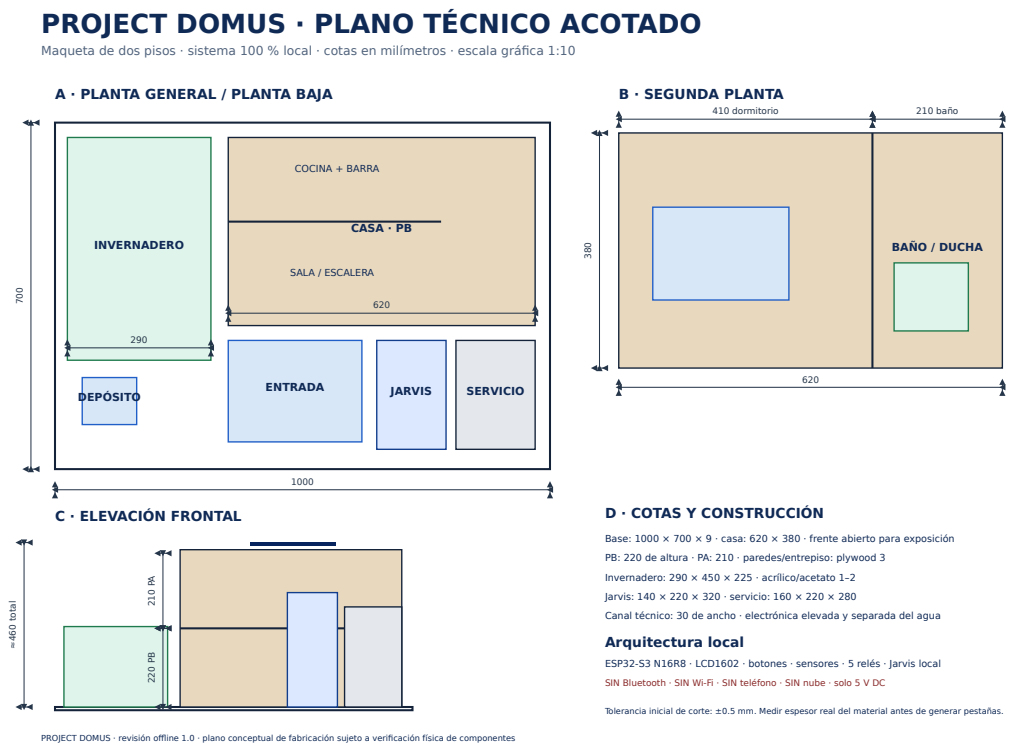
[picture p61: page 1]
INVERNADERO; CASA · PB; ENTRADA; JARVIS; SERVICIO DEPÓSITO; COCINA + BARRA; SALA / ESCALERA; B · SEGUNDA PLANTA; DORMITORIO; BAÑO / DUCHA; 410 dormitorio; 210 baño; ≈460 total; D · COTAS Y CONSTRUCCIÓN

A · PLANTA GENERAL / PLANTA BAJA

C · ELEVACIÓN FRONTAL 220 PB 210 PA

Base: 1000 × 700 × 9 · casa: 620 × 380 · frente abierto para exposición
PB: 220 de altura · PA: 210 · paredes/entrepiso: plywood 3
Invernadero: 290 × 450 × 225 · acrílico/acetato 1–2
Jarvis: 140 × 220 × 320 · servicio: 160 × 220 × 280
Canal técnico: 30 de ancho · electrónica elevada y separada del agua
Arquitectura local

ESP32-S3 N16R8 · LCD1602 · botones · sensores · 5 relés · Jarvis local
SIN Bluetooth · SIN Wi-Fi · SIN teléfono · SIN nube · solo 5 V DC

Tolerancia inicial de corte: ±0.5 mm. Medir espesor real del material antes de generar pestañas.

PROJECT DOMUS · revisión offline 1.0 · plano conceptual de fabricación sujeto a verificación física de componentes
