gvayoy-web/DOMUS/firmware/casa_inteligente_v4/domus_drivers.h

#pragma once
// PROJECT DOMUS — backends de driver de motores preparados pero INACTIVOS.
//
// Estado: NINGUNO por defecto. DRV8833 y MX1508 existen solo como descriptores
// (nombre + notas de cableado futuro); no asignan GPIO ni mueven hardware.
// Puerta F1 (validacion fisica: modulo identificado por foto + chip y tabla
// medida): DRIVER_MOTORES_LISTO significa "backend seleccionado + F1 superada".
// Hoy F1 no esta superada para ningun modulo: DOMUS_DRIVER_VALIDADO vale 0.
// Seleccionar un backend (-DDOMUS_DRIVER=1/2) solo prepara la compilacion;
// no autoriza cablear ni mover motores. La habilitacion exige además compilar
// con -DDOMUS_DRIVER_VALIDADO=1 después de identificar y medir el módulo.
// El despachador de casa_inteligente_v4.ino no cambia: `driver_no_listo` se
// revisa antes que `salida_no_instalada`.
//
// Seleccion por bandera de compilacion:
//   -DDOMUS_DRIVER=0 -> NINGUNO (seguro, predeterminado)
//   -DDOMUS_DRIVER=1 -> DRV8833 (preparado, inactivo hasta F1)
//   -DDOMUS_DRIVER=2 -> MX1508  (preparado, inactivo hasta F1)
//   -DDOMUS_DRIVER_VALIDADO=1 -> F1 acreditada físicamente (nunca por defecto)
// Otro valor falla por static_assert.
#include <stdint.h>

#ifndef DOMUS_DRIVER
#define DOMUS_DRIVER 0
#endif
#ifndef DOMUS_DRIVER_VALIDADO
#define DOMUS_DRIVER_VALIDADO 0
#endif

// Backend de driver separado, seleccionable por bandera. NINGUNO es el valor
// seguro predeterminado: no se adivina cual modulo llego.
enum class BackendMotor : uint8_t { NINGUNO = 0, DRV8833 = 1, MX1508 = 2 };

static_assert(DOMUS_DRIVER >= 0 && DOMUS_DRIVER <= 2,
              "DOMUS_DRIVER debe ser 0, 1 o 2");
static_assert(DOMUS_DRIVER_VALIDADO == 0 || DOMUS_DRIVER_VALIDADO == 1,
              "DOMUS_DRIVER_VALIDADO debe ser 0 o 1");

constexpr BackendMotor BACKEND_MOTOR_SELECCIONADO =
    DOMUS_DRIVER == 1 ? BackendMotor::DRV8833 :
    DOMUS_DRIVER == 2 ? BackendMotor::MX1508 :
                        BackendMotor::NINGUNO;

constexpr const char* nombreBackendMotor(BackendMotor b) {
  return b == BackendMotor::DRV8833 ? "DRV8833" :
         b == BackendMotor::MX1508 ? "MX1508" : "NINGUNO";
}

// --- Driver de motores (puerta F1) ---
// Seleccionar el backend NO acredita F1. La segunda bandera solo se cambia
// después de identificar físicamente el chip y medir su tabla de verdad.
constexpr bool DRIVER_MOTORES_LISTO =
    BACKEND_MOTOR_SELECCIONADO != BackendMotor::NINGUNO &&
    DOMUS_DRIVER_VALIDADO == 1;
// Orden que el driver confirmado ejecutará. Declaración del contrato;
// la definición vive en el driver de la placa identificada, no aquí.
struct OrdenMotorDriver {
  uint8_t canal;  // 0 = bomba, 1 = ventilador
  bool activar;
};
inline bool driverMotoresListo() { return DRIVER_MOTORES_LISTO; }
// Seguro por defecto: devuelve false (no mueve nada) hasta F1 superada.
// Ninguna llamada a esta funcion toca GPIO hoy.
inline bool driverMotoresAplicar(uint8_t canal, bool activar) {
  (void)canal;
  (void)activar;
  return false;
}

// --- Descriptores por backend (SIN pinouts) ---
// Solo nombre + notas de cableado futuro. Prohibido asignar GPIO aqui: el
// cableado real se define con F1, nunca antes.
struct DescriptorBackendMotor {
  const char* nombre;
  const char* notasCableadoFuturo;
};
constexpr DescriptorBackendMotor DESCRIPTOR_NINGUNO = {
  "NINGUNO",
  "Sin driver: ningun modulo adivinado; motores bloqueados hasta F1."
};
constexpr DescriptorBackendMotor DESCRIPTOR_DRV8833 = {
  "DRV8833",
  "Puente dual con entradas AIN1/AIN2/BIN1/BIN2 y pin nSLEEP; cableado futuro pendiente de F1, sin GPIO asignados."
};
constexpr DescriptorBackendMotor DESCRIPTOR_MX1508 = {
  "MX1508",
  "Puente dual con entradas IN1-IN4 y salidas OUT1-OUT4, sin pin SLEEP; cableado futuro pendiente de F1, sin GPIO asignados."
};
constexpr const DescriptorBackendMotor& descriptorBackendMotor(BackendMotor b) {
  return b == BackendMotor::DRV8833 ? DESCRIPTOR_DRV8833 :
         b == BackendMotor::MX1508 ? DESCRIPTOR_MX1508 : DESCRIPTOR_NINGUNO;
}

// El IR ya no pertenece a este archivo de drivers de motor. Su implementación
// y tabla aprendible viven en domus_ir_casa.h; el perfil activo decide si usa
// GPIO12. Esto evita mantener dos banderas contradictorias.

// --- Audio Jarvis (arquitectura definida, hardware aún bloqueado) ---
// La fuente será DFPlayer Mini por UART con MP3 en microSD. MAX98306 solo puede
// amplificar su salida DAC analógica. GPIO UART/BUSY siguen sin asignarse hasta
// la auditoría física descrita en la nota Obsidian 66.
constexpr bool AUDIO_CANDIDATO_HABILITADO = false;
