gvayoy-web/DOMUS/firmware/tests/test_firmware_contract.py

import unittest
from pathlib import Path


ROOT = Path(__file__).resolve().parents[2]
FIRMWARE = ROOT / "firmware" / "casa_inteligente_v4" / "casa_inteligente_v4.ino"
WORKFLOW = ROOT / ".github" / "workflows" / "firmware-ci.yml"


class FirmwareContractTests(unittest.TestCase):
    @classmethod
    def setUpClass(cls):
        cls.source = FIRMWARE.read_text(encoding="utf-8")
        cls.workflow = WORKFLOW.read_text(encoding="utf-8")

    def test_exactly_five_logical_outputs(self):
        self.assertRegex(self.source, r"#define\s+TOTAL_SALIDAS\s+5\b")
        self.assertNotRegex(self.source, r"PINES_SALIDAS\s*\[\s*8\s*\]")

    def test_relay_abstraction_is_gone(self):
        # Migración Fase E paso 1 (nota 46/52): cero restos de la abstracción de relés.
        for token in (
            "CANTIDAD_RELES", "PINES_RELES", "NOMBRES_RELES",
            "SALIDA_ACTIVA_EN_LOW", "RELE_ACTIVO_LOW", "RELE_ACTIVO_EN_LOW",
            "estadoReles", "propietarioReles",
            "encenderRele", "apagarRele",
            "verificarEstadoLogicoGpio", "fallosVerificacionRele",
            "USAR_DRV8833",
        ):
            self.assertNotIn(token, self.source)

    def test_arduino_prototypes_can_resolve_command_types(self):
        self.assertIn('#include "domus_types.h"', self.source)
        header = FIRMWARE.with_name("domus_types.h").read_text(encoding="utf-8")
        for declaration in ("enum OrigenOrden", "struct OrdenActuador", "struct ResultadoOrden"):
            self.assertIn(declaration, header)

    def test_serial_discards_entire_overlong_line_and_yields(self):
        serial = self.source.split("void revisarComandosSerial() {", 1)[1].split("void revisarControlesFisicos", 1)[0]
        self.assertIn("bytesProcesados < 128", serial)
        self.assertIn("descartarComandoHastaNuevaLinea = true", serial)
        self.assertIn("if (caracter == '\\n') descartarComandoHastaNuevaLinea = false", serial)
        self.assertLess(serial.index("if (descartarComandoHastaNuevaLinea)"), serial.index("procesarComandoTexto"))

    def test_adc_rails_are_rejected(self):
        import re
        for low, high in (("HUMEDAD_MIN_VALIDA", "HUMEDAD_MAX_VALIDA"),
                          ("NIVEL_AGUA_MIN_VALIDO", "NIVEL_AGUA_MAX_VALIDO"),
                          ("LDR_MIN_VALIDO", "LDR_MAX_VALIDO")):
            minimum = int(re.search(r"#define\s+" + low + r"\s+(\d+)", self.source)[1])
            maximum = int(re.search(r"#define\s+" + high + r"\s+(\d+)", self.source)[1])
            self.assertTrue(0 < minimum < maximum < 4095)

    def test_economical_outputs_require_explicit_selection(self):
        self.assertIn("#define DOMUS_SALIDAS_ECONOMICAS 0", self.source)
        self.assertNotIn("RELE_ACTIVO_EN_LOW", self.source)
        self.assertIn("nivelSalida(indice, true)", self.source)
        self.assertIn("nivelSalida(indice, false)", self.source)

    def test_invalid_gpio22_and_fake_wind_sensor_do_not_return(self):
        self.assertNotIn("GPIO22", self.source)
        self.assertNotIn("PIN_VIENTO", self.source)
        self.assertNotIn("leerViento", self.source)

    def test_firmware_has_no_ble_or_network_dependency(self):
        self.assertNotIn("NimBLE", self.source)
        self.assertNotIn("WiFi.h", self.source)
        self.assertNotIn("NimBLE-Arduino", self.workflow)

    def test_lcd_is_the_only_display_dependency(self):
        self.assertIn("LiquidCrystal_I2C", self.source)
        self.assertNotIn("Adafruit_SSD1306", self.source)
        self.assertNotIn("PANTALLA_OLED", self.source)
        product_job = self.workflow.split("compilar-perfiles-alfa:", 1)[0]
        self.assertNotIn("Adafruit SSD1306", product_job)

    def test_pump_has_level_and_timeout_interlocks(self):
        self.assertIn("nivel_agua_bajo", self.source)
        self.assertIn("TIEMPO_MAXIMO_BOMBA_MS", self.source)
        self.assertIn("verificarLimiteBomba();", self.source)

    def test_automatic_controls_have_separate_hysteresis_thresholds(self):
        self.assertRegex(
            self.source, r"#define\s+UMBRAL_HUMEDAD_SECA_PCT\s+35\b"
        )
        self.assertRegex(
            self.source, r"#define\s+UMBRAL_HUMEDAD_HUMEDA_PCT\s+45\b"
        )
        self.assertIn("pct >= UMBRAL_HUMEDAD_HUMEDA_PCT", self.source)
        self.assertRegex(
            self.source, r"#define\s+UMBRAL_TEMP_ALTA_C\s+28\.0\b"
        )
        self.assertRegex(
            self.source, r"#define\s+UMBRAL_TEMP_NORMAL_C\s+26\.0\b"
        )
        self.assertIn("tempC <= UMBRAL_TEMP_NORMAL_C", self.source)

    def test_emergency_stop_blocks_new_on_orders(self):
        self.assertIn("paroEmergenciaActivo && orden.encender", self.source)
        self.assertIn("activarParoEmergencia", self.source)
        self.assertIn("rearmarSistema", self.source)

    def test_health_supervisor_degrades_without_restart_loop(self):
        self.assertIn("MEMORIA_LIBRE_CRITICA_BYTES", self.source)
        self.assertIn("entrarModoSeguro(\"memoria_critica\")", self.source)
        self.assertIn("reiniciosCriticosConsecutivos >= 3", self.source)
        self.assertIn("modoSeguroActivo && orden.encender", self.source)
        self.assertIn("RECUPERAR", self.source)
        self.assertNotIn('esp_restart();', self.source)

    def test_no_speech_recognition_or_tinyml_runtime(self):
        for token in (
            "JARVIS_LOCAL_HABILITADO", "esp_afe_sr", "esp_mn_", "multinet",
            "modelo_mn", "MIC_WS_PIN", "TTS_BCLK_PIN",
        ):
            self.assertNotIn(token, self.source)
        self.assertIn("RECONOCIMIENTO_VOZ=NO_USADO", self.source)

    def test_serial_flood_is_limited_but_emergency_bypasses_limit(self):
        self.assertIn("MAX_COMANDOS_POR_SEGUNDO", self.source)
        self.assertIn('comando != "PARO" && !permitirComandoSerial()', self.source)
        self.assertIn("limite_de_frecuencia", self.source)

    def test_critical_sensor_failures_cut_automatic_outputs(self):
        self.assertIn("RIEGO_BLOQUEADO_SENSOR", self.source)
        self.assertIn("VENT_BLOQUEADO_SENSOR", self.source)
        self.assertIn("LUCES_AUTO_BLOQUEADAS_SENSOR", self.source)

    def test_mic_off_and_physical_backup_are_present(self):
        self.assertIn("MAPA_CASA.micOff", self.source)
        self.assertIn("MAPA_CASA.demo", self.source)
        self.assertIn("revisarControlesFisicos();", self.source)

    def test_micro_sd_has_real_read_write_self_test(self):
        self.assertIn("SD.begin", self.source)
        self.assertIn("domus_selftest.txt", self.source)
        self.assertIn("PROJECT_DOMUS_SD_OK", self.source)

    def test_uninstalled_sd_stays_disabled(self):
        self.assertRegex(self.source, r"#define\s+MICROSD_HABILITADA\s+false\b")

    def test_compile_time_pin_registry_prevents_duplicates(self):
        self.assertIn("PINES_RESERVADOS_DOMUS", self.source)
        self.assertIn("constexpr bool pinesDomusSonUnicos()", self.source)
        self.assertIn(
            'static_assert(pinesDomusSonUnicos(), "Hay GPIO duplicados en el mapa DOMUS")',
            self.source,
        )

    def test_all_assigned_optional_buses_are_reserved(self):
        registry = self.source.split(
            "constexpr int PINES_RESERVADOS_DOMUS[] = {", 1
        )[1].split("};", 1)[0]
        for symbol in (
            "SD_SCK_PIN",
            "SD_MISO_PIN",
            "SD_MOSI_PIN",
            "SD_CS_PIN",
        ):
            self.assertIn(symbol, registry)

    def test_future_buses_stay_unassigned(self):
        import re
        for symbol in ("MP3_RX_PIN", "MP3_TX_PIN"):
            match = re.search(rf"^#define\s+{symbol}\s+(-1)\b", self.source, re.M)
            self.assertIsNotNone(match, symbol)
        registry = self.source.split(
            "constexpr int PINES_RESERVADOS_DOMUS[] = {", 1
        )[1].split("};", 1)[0]
        self.assertNotIn("MP3_RX_PIN", registry)

    def test_map_is_the_single_pin_source(self):
        import re
        for token in (
            "PIN_HUMEDAD", "PIN_NIVEL_AGUA", "PIN_LDR", "PIN_PIR",
            "PIN_PARO_EMERGENCIA", "PIN_MIC_OFF", "PIN_BOTON_DEMO",
            "PIN_DHT11", "I2C_SDA_PIN", "I2C_SCL_PIN", "PINES_SALIDAS",
            "PIN_SALIDA_BOMBA",
        ):
            self.assertIsNone(
                re.search(rf"^#define\s+{token}\b", self.source, re.M), token)
        mapa = self.source.split("constexpr MapaPinesCasa MAPA_CASA = {", 1)[1].split("};", 1)[0]
        for literal in ("15", "16", "17", "18"):
            self.assertIn(literal, mapa)
        self.assertIn("MAPA_CASA.sda", self.source)
        self.assertIn("MAPA_CASA.salidas[indice]", self.source)

    def test_safety_threshold_order_is_checked_at_compile_time(self):
        for expression in (
            "UMBRAL_HUMEDAD_SECA_PCT < UMBRAL_HUMEDAD_HUMEDA_PCT",
            "UMBRAL_LUZ_OSCURO_PCT < UMBRAL_LUZ_CLARO_PCT",
            "UMBRAL_TEMP_NORMAL_C < UMBRAL_TEMP_ALTA_C",
            "MEMORIA_LIBRE_CRITICA_BYTES < MEMORIA_LIBRE_RECUPERACION_BYTES",
        ):
            self.assertIn(f"static_assert({expression}", self.source)

    def test_outputs_are_preloaded_off_before_output_mode(self):
        preload = "digitalWrite(MAPA_CASA.salidas[i], nivelSalida(i, false));"
        output = "pinMode(MAPA_CASA.salidas[i], SALIDA_FISICA_CASA[i] ? OUTPUT : INPUT);"
        setup = self.source.split("void setup()", 1)[1]
        self.assertLess(setup.index(preload), setup.index(output))

    def test_silence_button_does_not_block_ir_or_safety(self):
        dispatch = self.source.split("ResultadoOrden ejecutarOrdenActuador(const OrdenActuador &orden) {", 1)[1].split("\n}", 1)[0]
        self.assertNotIn("MAPA_CASA.micOff", dispatch)
        self.assertIn("EVENTO;SILENCIO;", self.source)
        self.assertIn("ORIGEN_IR", self.source)
        self.assertIn("EVENTO;SILENCIO;", self.source)


if __name__ == "__main__":
    unittest.main(verbosity=2)
