gvayoy-web/DOMUS/(commit log)

2026-09-01 Proyecto DOMUS: documentación, planos y firmware inicial
    [partitions.csv]
2026-09-01 Completar fase 2 de compilación del firmware
2026-09-02 Actualizar proyecto y auditoria de compras
2026-09-02 Incluir deliverables y guia de migracion
    [bom_componentes.csv, lista_corte.csv, piezas_modelo.csv, project_domus.obj]
2026-09-03 Finalizar firmware, pruebas y diseño técnico de DOMUS
    [piezas_modelo.csv, project_domus.obj]
2026-09-04 Completar firmware, planes, planos y visualizaciones DOMUS
    [lista_corte.csv, lista_corte_ultimate.csv, materiales_ultimate.csv, perforaciones_y_accesos.csv, piezas_modelo.csv, project_domus.obj]
2026-09-04 Documentar auditoria multientorno de DOMUS
2026-09-05 Corregir firmware y validar perfiles de salidas economicas
    [bom_componentes.csv]
2026-09-05 Usar identificador QSPI correcto del core ESP32 en CI
2026-09-05 Cerrar watchdog I2C calibracion persistente y cola SD con pruebas integradas
2026-09-05 Preparar entrenamiento int8 con auditoria de datos y verificar rutas de audio
2026-09-05 Validar escaneo I2C y documentar cierre real sin declarar IA entrenada
2026-09-05 Registrar verificacion final de robustez en verde [skip ci]
2026-09-07 docs: align DOMUS vault and Arduino setup
2026-09-07 Alinear DOMUS con perfil de cinco reles y planos v4
2026-09-08 Preparar ronda de banco N16R8 sin actuadores
2026-09-08 Explicar conexion LCD I2C en guia de banco
2026-09-08 Documentar bomba S8050 y diagnostico de fallas
2026-09-10 Diagramas v2: cadena 120V-5V/5A-fusible 4A, IR GPIO12, BTN 16, buzzer nucleo, mando 21 teclas firmware; standalone regenerado
    [regen_standalone.py, validate_project.py]
2026-09-10 Diagrama final 2 paginas modo mortales: reconocer cada pieza + cable exacto; sistema-domus sin INMP
2026-09-10 Diagramas visuales SVG en diagrama-final: mapa esqueleto 3V3 y mapa final 5V
2026-09-10 Esqueleto v2.1: UART pacing verificado en COM9 (DIAG 4/4, IR 21/21), LCD no muestra % sin CAL, contrato v2 + plan codigo final
2026-09-10 Diagrama-final legible: etiquetas por cable, leyenda pines ESP32, fix cable MAX, pasos sin simplificar (colores, riel 5V, posiciones fisicas)
2026-09-12 Ola 1: buffers LCD/Jarvis, Jarvis unico + ACK condicional, GPIO12 reservado (BUZZER off), validacion GPIO por perfil, ALFA_BOMBA_1/VENTILADOR_1, splash/beep no bloqueantes, SVG + Obsidian 46/47/48/49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
    [domus_config.h, domus_esqueleto.ino, domus_lcd.h, domus_voice.h, validate_project.py]
2026-09-12 Ola 1 correctivo: PerfilHardware seleccion unica + matriz compilacion, tests contrato+HIL alfa, README GPIO12, SVG una-carga, validador seleccion unica, nota 50 addendum
    [domus_config.h, test_domus_esqueleto_contract.py, validate_project.py]
2026-09-12 Boveda autocontenida 38-45: notas existentes sin seguimiento (sin edicion) para vault reproducible
2026-09-12 Ola 1 entrega 3: IR/DF/buzzer prohibidos en alfa, matriz sin SKIP silencioso + PATH, CI rechazos, PERFIL_PRUEBA verificado en binario
    [check_perfil_matrix.py, domus_config.h, test_domus_esqueleto_contract.py, validate_project.py]
2026-09-12 Ola 3 fix: contrato cableado a PIN_SALIDA_* tras migracion
    [validate_project.py]
2026-09-12 Ola 3: nota 52 documenta contrato cableado migrado
2026-09-12 Cierre auditoria 4: energia 2 ramas, arquitectura renombrada, guia final pin-por-pin, nota 53 firmware-final F1-F7, casa CANDIDATO, test nativo C++
2026-09-12 Candidato casa: PerfilCasa+MapaPinesCasa+mascara+drivers, tests candidato, CI 7 perfiles, plan orden repo nota 54
2026-09-12 Auditoria 5: mapa 15/16/17/18 fuente real, driver antes que etapa, MIC/MP3 sin asignar, despacho probado x2 motivos
2026-09-12 Orden fase 1: P2 assert campos-arreglo, gitignore RAR-tmp-artefactos, docs INDICE, README raiz, nota 56
    [casa_inteligente_v4.ino]
2026-09-12 LCD final 16x2: PantallaFinal diferencial con 5 vistas y prioridad de emergencia
    Clase autocontenida (saludo no bloqueante, campos fijos %-16.16s, sombra char[2][17], iconos CGRAM, ERR ante sensor invalido, LCD nulo tolerado). El .ino delega dibujo (begin/tick/siguiente) y conserva protocolo, seguridad, automatizacion, escaneo I2C y antirebote. Test nativo FMT/PRIO/ERR/TICK mas controles de texto.
2026-09-12 Integra LCD+drivers (cherry-pick) + movimiento 1: hardware/ con 3 archivos y enlaces GUIA
2026-09-12 fix: harden final candidate and canonical hardware bundle
    [project_domus.obj]
2026-09-13 chore: consolida planos en hardware
    [lista_corte.csv, lista_corte_ultimate.csv, materiales_ultimate.csv, perforaciones_y_accesos.csv, piezas_modelo.csv, project_domus.obj]
2026-09-13 chore: ordena raiz y rutas canonicas
    [lista_corte.csv, piezas_modelo.csv, project_domus.obj]
2026-09-13 test: muestra errores nativos completos
    [test_native_firmware.py]
2026-09-13 fix: sincroniza harness nativo con perfil de banco
    [native_integration.cpp, test_native_firmware.py, test_native_safety.py]
2026-09-13 ci: instala dependencias canonicas de planos
2026-09-13 ci: instala IRremote en matrices ESP32
2026-09-13 docs: amplia reporte de pruebas y pendientes
2026-09-13 feat: preparar banco actual para pruebas HIL
2026-09-13 fix: declarar funciones del firmware incluido
    [domus_esqueleto.ino, test_esqueleto_unico_y_diagnostico.py]
2026-09-15 docs: consolidar autoridad Obsidian y retirar TinyML
    [partitions.csv]
2026-09-15 docs: diagramar conexiones de los seis sketches DOMUS
2026-09-16 docs: registrar pruebas fisicas de DOMUS
2026-09-16 fix: estabilizar LCD y aislar DHT defectuoso
    [casa_inteligente_v4.ino, domus_ir_casa.h, domus_pantalla.h, test_pantalla_final.py]
2026-09-16 docs: cerrar bitacora fisica de la sesion
2026-09-16 fix: reducir reloj I2C del banco LCD
    [casa_inteligente_v4.ino]
2026-09-17 docs: definir arquitectura final completa de DOMUS
